INITRAMFS-AUC/KWS-SoC/(list of files, cad)

Other CAD files:
quartus/CycloneV/stp1.stp
