INITRAMFS-AUC/KWS-SoC/scripts/gen_pll.py

#!/usr/bin/env python3
"""
Generate a Quartus ALTPLL wrapper for any integer output frequency.

Strategy: patch the four synthesis-critical defparam values in
quartus/ip/ALTPLL_25/ALTPLL_25.v (wizard-generated, proven base) and
write the result as quartus/ip/clock_pll_gen/clock_pll_gen.v.
Everything else (port wiring, unused-port declarations, retrieval info)
is left byte-for-byte identical to the wizard output.

Usage:
    python3 scripts/gen_pll.py --clk-mhz 36 --device-family "Cyclone V"
"""

import argparse
import math
import os
import re
import sys

SCRIPT_DIR   = os.path.dirname(os.path.abspath(__file__))
REPO_ROOT    = os.path.dirname(SCRIPT_DIR)
TEMPLATE_V   = os.path.join(REPO_ROOT, "quartus/ip/ALTPLL_25/ALTPLL_25.v")
TEMPLATE_BB  = os.path.join(REPO_ROOT, "quartus/ip/ALTPLL_25/ALTPLL_25_bb.v")
OUT_DIR      = os.path.join(REPO_ROOT, "quartus/ip/clock_pll_gen")
MODULE_NAME  = "clock_pll_gen"
REF_MHZ      = 50

# Cyclone V ALTPLL hardware limits.  The VCO frequency (= REF_MHZ × M
# in lowest-terms M/C) must land inside the device's PLL VCO band, or
# Quartus will fail at fit time with a cryptic timing-closure error.
# These are the typical Cyclone V numbers; tighten if your specific
# speed grade differs.
VCO_MIN_MHZ  = 600
VCO_MAX_MHZ  = 1300

# ALTPLL counter ranges (M = multiplier, C = output divider).
M_MIN, M_MAX = 1,   256
C_MIN, C_MAX = 1,   512


def cyclone_v_admissible(clk_mhz):
    """True iff (M, C) for `clk_mhz` lands inside Cyclone V VCO + counter limits."""
    m, c = compute_mc(clk_mhz)
    if not (M_MIN <= m <= M_MAX): return False
    if not (C_MIN <= c <= C_MAX): return False
    vco = REF_MHZ * m
    return VCO_MIN_MHZ <= vco <= VCO_MAX_MHZ


def nearby_valid_clk_mhz(clk_mhz, span=12, target_count=4):
    """Adjacent CLK_MHZ values that DO meet the VCO/counter constraints,
    so the error message can suggest concrete alternatives.  Falls back
    to a globally-enumerated list if nothing is found within ±`span`."""
    candidates = []
    for delta in range(1, span + 1):
        for c in (clk_mhz - delta, clk_mhz + delta):
            if c <= 0: continue
            if cyclone_v_admissible(c):
                candidates.append(c)
        if len(candidates) >= target_count:
            break
    if candidates:
        return sorted(set(candidates))
    # Fallback: enumerate the practical CLK range and return a few.
    fallback = [c for c in range(1, 200) if cyclone_v_admissible(c)]
    return fallback[:target_count] if fallback else []


def compute_mc(clk_mhz):
    """Return (M, C) such that REF_MHZ * M / C == clk_mhz, in lowest terms."""
    g = math.gcd(clk_mhz, REF_MHZ)
    return clk_mhz // g, REF_MHZ // g


def patch(text, old_name, new_name, m, c, device_family, freq_mhz):
    """Apply all substitutions to the template text."""

    # --- Verilog body (synthesis-critical) ---
    text = re.sub(r'\bmodule\s+' + re.escape(old_name) + r'\b',
                  f'module {new_name}', text)
    text = re.sub(r'(altpll_component\.clk0_divide_by\s*=\s*)\d+',
                  rf'\g<1>{c}', text)
    text = re.sub(r'(altpll_component\.clk0_multiply_by\s*=\s*)\d+',
                  rf'\g<1>{m}', text)
    text = re.sub(r'(altpll_component\.intended_device_family\s*=\s*)"[^"]*"',
                  rf'\g<1>"{device_family}"', text)
    text = re.sub(r'(altpll_component\.lpm_hint\s*=\s*"CBX_MODULE_PREFIX=)' + re.escape(old_name) + r'"',
                  rf'\g<1>{new_name}"', text)

    # --- Retrieval-info comments (wizard bookkeeping only) ---
    text = re.sub(r'(CONSTANT: CLK0_DIVIDE_BY NUMERIC )"[^"]*"',
                  rf'\g<1>"{c}"', text)
    text = re.sub(r'(CONSTANT: CLK0_MULTIPLY_BY NUMERIC )"[^"]*"',
                  rf'\g<1>"{m}"', text)
    text = re.sub(r'(CONSTANT: INTENDED_DEVICE_FAMILY STRING )"[^"]*"',
                  rf'\g<1>"{device_family}"', text)
    text = re.sub(r'(PRIVATE: INTENDED_DEVICE_FAMILY STRING )"[^"]*"',
                  rf'\g<1>"{device_family}"', text)
    text = re.sub(r'(PRIVATE: OUTPUT_FREQ0 STRING )"[^"]*"',
                  rf'\g<1>"{freq_mhz:.8f}"', text)
    text = re.sub(r'(PRIVATE: EFF_OUTPUT_FREQ_VALUE0 STRING )"[^"]*"',
                  rf'\g<1>"{freq_mhz:.6f}"', text)

    # Rename all remaining old_name occurrences (GEN_FILE lines, file header comment, etc.)
    text = text.replace(old_name, new_name)

    return text


def write_qip(out_dir, module_name, device_family):
    qip_path = os.path.join(out_dir, f"{module_name}.qip")
    with open(qip_path, "w") as fh:
        fh.write(f'set_global_assignment -name IP_TOOL_NAME "ALTPLL"\n')
        fh.write(f'set_global_assignment -name IP_TOOL_VERSION "25.1"\n')
        fh.write(f'set_global_assignment -name IP_GENERATED_DEVICE_FAMILY "{{{device_family}}}"\n')
        fh.write(f'set_global_assignment -name VERILOG_FILE [file join $::quartus(qip_path) "{module_name}.v"]\n')
        fh.write(f'set_global_assignment -name MISC_FILE [file join $::quartus(qip_path) "{module_name}_bb.v"]\n')


def main():
    parser = argparse.ArgumentParser(description=__doc__,
                                     formatter_class=argparse.RawDescriptionHelpFormatter)
    parser.add_argument("--clk-mhz",      type=int,   required=True,
                        help="Target output frequency in MHz (integer)")
    parser.add_argument("--device-family", default="Cyclone V",
                        help="Intel FPGA device family (default: 'Cyclone V')")
    args = parser.parse_args()

    clk_mhz = args.clk_mhz
    m, c = compute_mc(clk_mhz)
    f_check = REF_MHZ * m / c
    if abs(f_check - clk_mhz) > 0.001:
        sys.exit(f"ERROR: {clk_mhz} MHz is not exactly achievable from {REF_MHZ} MHz as an integer ratio")

    # Hardware-feasibility checks.  Quartus will silently accept an
    # out-of-range VCO and only complain at fit time with an obscure
    # timing failure — fail loudly here instead so the user knows
    # immediately *why* their CLK_MHZ doesn't work.
    vco = REF_MHZ * m
    if not (M_MIN <= m <= M_MAX):
        nearby = nearby_valid_clk_mhz(clk_mhz)
        suggestion = f"Try one of: {', '.join(map(str, nearby))} MHz." if nearby \
                     else "(no admissible CLK_MHZ found near this value)"
        sys.exit(
            f"ERROR: CLK_MHZ={clk_mhz} requires M={m}, outside the\n"
            f"       Cyclone V ALTPLL multiplier range [{M_MIN}..{M_MAX}].\n"
            f"       {suggestion}")
    if not (C_MIN <= c <= C_MAX):
        nearby = nearby_valid_clk_mhz(clk_mhz)
        suggestion = f"Try one of: {', '.join(map(str, nearby))} MHz." if nearby \
                     else "(no admissible CLK_MHZ found near this value)"
        sys.exit(
            f"ERROR: CLK_MHZ={clk_mhz} requires C={c}, outside the\n"
            f"       Cyclone V ALTPLL output-divider range [{C_MIN}..{C_MAX}].\n"
            f"       {suggestion}")
    if not (VCO_MIN_MHZ <= vco <= VCO_MAX_MHZ):
        nearby = nearby_valid_clk_mhz(clk_mhz)
        suggestion = f"Try one of: {', '.join(map(str, nearby))} MHz." if nearby \
                     else "(no admissible CLK_MHZ found near this value)"
        sys.exit(
            f"ERROR: CLK_MHZ={clk_mhz} → M={m}, C={c} → VCO={vco} MHz,\n"
            f"       outside the Cyclone V ALTPLL VCO band\n"
            f"       [{VCO_MIN_MHZ}..{VCO_MAX_MHZ}] MHz.  Quartus would accept\n"
            f"       this but fail at fit-time timing closure.\n"
            f"       {suggestion}")
    print(f"[gen_pll] CLK_MHZ={clk_mhz} → M={m}, C={c}, VCO={vco} MHz (OK)")

    os.makedirs(OUT_DIR, exist_ok=True)

    old_name = "ALTPLL_25"

    for src, dst_name in [(TEMPLATE_V,  f"{MODULE_NAME}.v"),
                          (TEMPLATE_BB, f"{MODULE_NAME}_bb.v")]:
        with open(src) as fh:
            text = fh.read()
        text = patch(text, old_name, MODULE_NAME, m, c, args.device_family, float(clk_mhz))
        dst = os.path.join(OUT_DIR, dst_name)
        with open(dst, "w") as fh:
            fh.write(text)

    write_qip(OUT_DIR, MODULE_NAME, args.device_family)

    print(f"Generated {clk_mhz} MHz PLL (M={m}, C={c}, family={args.device_family!r}) → {OUT_DIR}/")


if __name__ == "__main__":
    main()
