INITRAMFS-AUC/KWS-SoC/test/i2s/c/readI2s.c

#include <stdint.h>
#include "uart.h"
#include "i2s_regs.h"

#define I2S_BASE_ADDR  0x40008000
#define I2S            ((i2s_hw_t *)I2S_BASE_ADDR)

/* Half-full threshold = FIFO_DEPTH/2; the Makefile derives I2S_DMA_BURST_WORDS
 * from the same root variable, so reading that many words per IRQ matches the
 * peripheral's interrupt point exactly. */
#ifndef I2S_DMA_BURST_WORDS
#error "I2S_DMA_BURST_WORDS must be defined by the Makefile"
#endif
#define I2S_HALF_FULL I2S_DMA_BURST_WORDS

/* One pattern pass from sim/debug_audio.hex (comments and blanks stripped).
 * These are the raw 32-bit I2S words fed by the simulator.
 * Firmware-equivalent quantization: (int8_t)(raw >> 16) == HW q8_en extraction.
 *
 * The first 2 entries are warmup zeros: the I2S clock generator fires two
 * phantom data_left_en pulses (first two WS frames) before the simulator
 * starts driving real data.  raw_data_l=0 during those frames, so bits[23:16]
 * are 0x00, and pack_cnt advances from 0->2 before the first real sample.
 * Prepending two 0x00000000 entries aligns expected[] with the received stream. */
static const uint32_t expected_raw[] = {
    /* Warmup: 2 phantom WS frames before simulator data begins */
    0x00000000, 0x00000000,
    /* Magic words */
    0xDEADBEEF, 0xCAFEBABE, 0x0BADF00D, 0xFACEFEED,
    /* Walking 1 */
    0x80000000, 0x40000000, 0x20000000, 0x10000000,
    0x08000000, 0x04000000, 0x02000000, 0x01000000,
    /* Walking 0 */
    0x7FFFFFFF, 0xBFFFFFFF, 0xDFFFFFFF, 0xEFFFFFFF,
    /* Counting */
    0x00000001, 0x00000002, 0x00000003, 0x00000004,
    0x00000005, 0x00000006, 0x00000007, 0x00000008,
    /* Alternating */
    0xAAAAAAAA, 0x55555555,
};
#define NUM_EXPECTED ((int)(sizeof(expected_raw) / sizeof(expected_raw[0])))

static volatile int exp_idx    = 0;
static volatile int pass_count = 0;
static volatile int fail_count = 0;
static volatile int done       = 0;

uint32_t i2s_get_id(void) {
    return I2S->id;
}

void i2s_configure(uint32_t clk_div, uint8_t int_en, uint8_t ds_en, uint8_t q8_en) {
    uint32_t conf_val = 0;
    conf_val |= ((clk_div << I2S_CONF_DIV_LSB)    & I2S_CONF_DIV_MASK);
    conf_val |= ((int_en  << I2S_CONF_IRQ_EN_LSB) & I2S_CONF_IRQ_EN_MASK);
    /* conf_val |= ((ds_en   << I2S_CONF_DS_EN_LSB)  & I2S_CONF_DS_EN_MASK); */
    /* q8_en=1 maps to WIDTH=8 (8-bit packing) in the new width-aware regblock. */
    if (q8_en)
        conf_val |= (((uint32_t)I2S_CONF_WIDTH_8 << I2S_CONF_WIDTH_LSB) & I2S_CONF_WIDTH_MASK);
    I2S->conf = conf_val;
}

void __attribute__((interrupt("machine"))) i2s_isr(void) {
    if (done) return;

    for (int i = 0; i < I2S_HALF_FULL; i++) {
        uint32_t word = I2S->fifo;  /* 4 packed HW-quantized int8 samples */

        for (int s = 24; s >= 0; s -= 8) {
            if (exp_idx >= NUM_EXPECTED) {
                done = 1;
                return;
            }

            /* HW-produced int8 (already quantized and packed by peripheral) */
            uint8_t rx  = (uint8_t)(word >> s);

            /* Firmware-equivalent: same extraction the HW performs on the raw word */
            uint8_t exp = (uint8_t)(expected_raw[exp_idx] >> 16);

            int ok = (rx == exp);
            uart_printf("[%x] rx=0x%x  exp=0x%x  %s\r\n",
                        (uint32_t)exp_idx, (uint32_t)rx, (uint32_t)exp,
                        ok ? "PASS" : "FAIL");

            if (ok) pass_count++; else fail_count++;
            exp_idx++;
        }
    }
}

static inline void csr_set_mtvec(void (*handler)(void)) {
    asm volatile ("csrw mtvec, %0" :: "r"((uintptr_t)handler));
}

static inline void csr_enable_meie(void) {
    asm volatile ("csrs mie, %0" :: "r"(1u << 11));
}

static inline void csr_enable_mie(void) {
    asm volatile ("csrsi mstatus, 8");
}

static inline void wfi(void) {
    asm volatile ("wfi");
}

int main(void) {
    uart_init();
    uart_printf("[I2S q8 test] ID: 0x%x\r\n", i2s_get_id());
    uart_printf("Expecting %x samples from debug_audio.hex\r\n\r\n",
                (uint32_t)NUM_EXPECTED);

    csr_set_mtvec(i2s_isr);
    csr_enable_meie();
    /* ds_en=0: no downsampling so all samples arrive in hex-file order.
     * q8_en=1: HW extracts raw[23:16] and packs 4 int8s per 32-bit FIFO word. */
    i2s_configure(4, 1, 0, 1);
    csr_enable_mie();

    while (!done) { wfi(); }

    uart_printf("\r\n=== RESULT: %x PASS  %x FAIL ===\r\n",
                (uint32_t)pass_count, (uint32_t)fail_count);
    return 0;
}
