INITRAMFS-AUC/KWS-SoC/test/uart/c/hello_world.c

#include <stdint.h>

// --- UART REGISTER DEFINITIONS ---
#define UART_BASE  0x40004000
#define UART_CSR   (*(volatile uint32_t *)(UART_BASE + 0x00))
#define UART_DIV   (*(volatile uint32_t *)(UART_BASE + 0x04))
// Assumes FSTAT is at offset 0x08 based on previous context
#define UART_FSTAT (*(volatile uint32_t *)(UART_BASE + 0x08))
#define UART_TX    (*(volatile uint32_t *)(UART_BASE + 0x0C))

#define UART_CSR_EN       (1 << 0)
#define UART_FSTAT_TXFULL (1 << 8) // Validated against "fstat_txfull_i" in Verilog

// --- CONFIGURATION ---
#ifndef CLK_MHZ
    #error "CLK_MHZ is not defined. Check your Makefile variables!"
#endif
#ifndef UART_BAUD_RATE
    #error "UART_BAUD_RATE is not defined. Check your Makefile variables!"
#endif

// --- BAUD CALCULATION ---
// Convert MHz to Hz
#define SYS_CLK_HZ  ((uint32_t)(CLK_MHZ * 1000000UL))

// Calculate Fractional Divisor - Based on uart_mini
// Hardware requires 8x Oversampling and uses 4 fractional bits (x16 scale).
// Formula: (CLK / (Baud * 8)) * 16  ==>  (CLK / Baud) * 2
// We apply rounding logic: ((2*CLK) + (Baud/2)) / Baud
#define UART_DIV_VAL  (((2 * SYS_CLK_HZ) + (UART_BAUD_RATE / 2)) / UART_BAUD_RATE)

void uart_init() {
    // Set the fractional divisor
    UART_DIV = UART_DIV_VAL;

    // Enable UART (Loopback, Interrupts etc. handled here if needed)
    UART_CSR |= UART_CSR_EN;
}

void uart_putc(char c) {
    // Wait for TX FIFO to be not full
    while (UART_FSTAT & UART_FSTAT_TXFULL);
    UART_TX = c;
}

void uart_puts(const char *s) {
    while (*s) uart_putc(*s++);
}

int main() {
    uart_init();
    while (1) {
        uart_puts("Hello World!\r\n");
    }
    return 0;
}
