INITRAMFS-AUC/KWS-SoC/test/model/mel_compact_int8_pi/mel_compact_int8_pi.h

#include "nnom.h"

/* Weights, bias and Q format */
#define TENSOR_CONV1D_MEL_KERNEL_0 {-30, -11, 15, 34, 45, 51, 45, 27, 20, -12, -34, -44, -53, -54, -52, -41, -35, -10, 23, 38, 56, 67, 67, 59, 42, 13, -5, -39, -66, -81, -81, -62, -50, -15, 2, 36, 50, 72, 68, 68, 46, 27, 0, -31, -48, -56, -58, -61, -55, -31, 2, 28, 51, 67, 63, 56, 41, 28, 2, -2, -23, -43, -48, -47, -36, -37, -37, -26, -33, -42, -56, -68, -64, -62, -66, -59, -54, -43, -35, -29, -16, -15, 8, 29, 46, 57, 63, 67, 78, 94, 92, 88, 82, 83, 83, 75, 63, 46, 32, 17, 13, -2, -23, -33, -43, -60, -63, -68, -68, -76, -73, -75, -75, -68, -60, -51, -40, -23, -12, -12, -5, 6, 2, 9, 17, 15, 11, 16, 15, 18, -9, 11, 23, 32, 44, 47, 59, 56, 55, 50, 48, 35, 27, 6, -10, -30, -45, -60, -70, -70, -70, -67, -62, -61, -42, -29, -10, 12, 30, 60, 64, 60, 68, 78, 74, 76, 77, 71, 61, 37, 18, 4, -6, -14, -25, -37, -51, -70, -69, -63, -55, -42, -34, -17, -7, 4, 8, 16, 22, 26, 48, 41, 37, 30, 34, 34, 14, -21, -30, -41, -30, -31, -30, -15, -10, 7, 32, 48, 79, 86, 76, 65, 43, 37, -9, -34, -60, -83, -92, -97, -76, -47, -21, -7, 20, 60, 94, 103, 108, 86, 62, 36, 3, -18, -45, -72, -84, -85, -67, -54, -33, -18, 13, 43, 55, 58, 69, 67, 53, 31, 13, -5, -11, -22, -22, -34, -32, -20, 6, 21, -22, -22, 2, 30, 29, 31, 31, 23, 8, -19, -30, -49, -51, -49, -30, -3, 24, 41, 60, 62, 58, 42, 15, -22, -53, -80, -87, -78, -51, -9, 32, 65, 94, 94, 90, 48, 6, -46, -86, -105, -104, -86, -40, 16, 69, 88, 97, 92, 55, 6, -35, -69, -75, -71, -59, -20, 13, 40, 40, 45, 37, 15, 8, -27, -33, 10, -1, -7, -15, -12, -4, 14, 27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

#define TENSOR_DENSE_FC_KERNEL_0_DEC_BITS {6}

#define TENSOR_DENSE_FC_BIAS_0 {42, 61, 21, 67, 6, 28, -30, 16, 104, 21, 5, -7, -2, 45, 11, -32}

#define TENSOR_DENSE_FC_BIAS_0_DEC_BITS {9}

#define DENSE_FC_BIAS_LSHIFT {0}

#define DENSE_FC_OUTPUT_RSHIFT {5}

#define TENSOR_DENSE_OUT_KERNEL_0 {14, -44, -40, -37, 18, -30, 15, -39, -40, -51, -27, -21, -40, -58, -43, 18, 19, 19, 18, 10, -54, 20, -50, -28, 26, -19, -42, 14, -42, -45, -45, 14, -22, -52, -39, -35, 26, -31, 18, 11, -37, -40, 16, 21, 12, -45, -12, -10, -25, 18, -31, 21, -11, -38, -12, 20, -33, -53, 15, -30, -43, -53, 14, 12, -46, 15, 11, -36, 20, -43, -26, 16, 21, 21, 17, 14, 22, -25, -28, -27, -43, 9, 7, 13, -37, -48, 13, 16, -23, 22, 15, 9, -37, 24, -33, 6, 7, 24, -42, -56, 27, -22, 14, -49, 7, -39, -61, -55, -22, 12, 16, 6, -10, -52, -45, -33, -32, 31, 20, -47, 16, 17, -1, -41, -42, -25, -54, -30, -50, 20, 12, 13, -85, 16, -41, 9, 23, 9, 2, -62, 21, 12, -72, -62, -27, -40, 17, -51, -49, -60, -55, -51, -20, 14, 12, 18, -38, -26, 18, 15, 5, 14, -49, -67, 8, 10, -20, -43, -47, -53, 12, -28, 31, 17, 9, -32}

#define TENSOR_DENSE_OUT_KERNEL_0_DEC_BITS {5}

#define TENSOR_DENSE_OUT_BIAS_0 {34, 51, 16, 45, -64, -102, -39, -1, -92, 36, 77}

#define TENSOR_DENSE_OUT_BIAS_0_DEC_BITS {7}

#define DENSE_OUT_BIAS_LSHIFT {3}

#define DENSE_OUT_OUTPUT_RSHIFT {9}


/* output q format for each layer */
#define AUDIO_INPUT_OUTPUT_DEC 7
#define AUDIO_INPUT_OUTPUT_OFFSET 0
#define CONV1D_MEL_OUTPUT_DEC 4
#define CONV1D_MEL_OUTPUT_OFFSET 0
#define BATCH_NORMALIZATION_1_OUTPUT_DEC 4
#define BATCH_NORMALIZATION_1_OUTPUT_OFFSET 0
#define RE_LU_1_OUTPUT_DEC 4
#define RE_LU_1_OUTPUT_OFFSET 0
#define MAX_POOLING_2_OUTPUT_DEC 4
#define MAX_POOLING_2_OUTPUT_OFFSET 0
#define CONV1D_2_OUTPUT_DEC 3
#define CONV1D_2_OUTPUT_OFFSET 0
#define BATCH_NORMALIZATION_2_OUTPUT_DEC 3
#define BATCH_NORMALIZATION_2_OUTPUT_OFFSET 0
#define RE_LU_2_OUTPUT_DEC 3
#define RE_LU_2_OUTPUT_OFFSET 0
#define MAX_POOLING_3_OUTPUT_DEC 3
#define MAX_POOLING_3_OUTPUT_OFFSET 0
#define CONV1D_3_OUTPUT_DEC 4
#define CONV1D_3_OUTPUT_OFFSET 0
#define BATCH_NORMALIZATION_3_OUTPUT_DEC 4
#define BATCH_NORMALIZATION_3_OUTPUT_OFFSET 0
#define RE_LU_3_OUTPUT_DEC 4
#define RE_LU_3_OUTPUT_OFFSET 0
#define MAX_POOLING_4_OUTPUT_DEC 4
#define MAX_POOLING_4_OUTPUT_OFFSET 0
#define CONV1D_4_OUTPUT_DEC 4
#define CONV1D_4_OUTPUT_OFFSET 0
#define BATCH_NORMALIZATION_4_OUTPUT_DEC 4
#define BATCH_NORMALIZATION_4_OUTPUT_OFFSET 0
#define RE_LU_4_OUTPUT_DEC 4
#define RE_LU_4_OUTPUT_OFFSET 0
#define CONV1D_5_OUTPUT_DEC 3
#define CONV1D_5_OUTPUT_OFFSET 0
#define BATCH_NORMALIZATION_5_OUTPUT_DEC 3
#define BATCH_NORMALIZATION_5_OUTPUT_OFFSET 0
#define RE_LU_5_OUTPUT_DEC 3
#define RE_LU_5_OUTPUT_OFFSET 0
#define GLOBAL_AVERAGE_POOLING_OUTPUT_DEC 3
#define GLOBAL_AVERAGE_POOLING_OUTPUT_OFFSET 0
#define DENSE_FC_OUTPUT_DEC 4
#define DENSE_FC_OUTPUT_OFFSET 0
#define RE_LU_FC_OUTPUT_DEC 5
#define RE_LU_FC_OUTPUT_OFFSET 0
#define DROPOUT_OUTPUT_DEC 5
#define DROPOUT_OUTPUT_OFFSET 0
#define DENSE_OUT_OUTPUT_DEC 1
#define DENSE_OUT_OUTPUT_OFFSET 0
#define SOFTMAX_OUTPUT_DEC 7
#define SOFTMAX_OUTPUT_OFFSET 0

/* bias shift and output shift for none-weighted layer */

/* tensors and configurations for each layer */
static int8_t nnom_input_data[8000] = {0};

const nnom_shape_data_t tensor_audio_input_dim[] = {8000, 1};
const nnom_qformat_param_t tensor_audio_input_dec[] = {7};
const nnom_qformat_param_t tensor_audio_input_offset[] = {0};
const nnom_tensor_t tensor_audio_input = {
    .p_data = (void*)nnom_input_data,
    .dim = (nnom_shape_data_t*)tensor_audio_input_dim,
    .q_dec = (nnom_qformat_param_t*)tensor_audio_input_dec,
    .q_offset = (nnom_qformat_param_t*)tensor_audio_input_offset,
    .qtype = NNOM_QTYPE_PER_TENSOR,
    .num_dim = 2,
    .bitwidth = 8
};

const nnom_io_config_t audio_input_config = {
    .super = {.name = "audio_input"},
    .tensor = (nnom_tensor_t*)&tensor_audio_input
};
const int8_t tensor_conv1d_mel_kernel_0_data[] = TENSOR_CONV1D_MEL_KERNEL_0;

const nnom_shape_data_t tensor_conv1d_mel_kernel_0_dim[] = {65, 1, 16};
const nnom_qformat_param_t tensor_conv1d_mel_kernel_0_dec[] = TENSOR_CONV1D_MEL_KERNEL_0_DEC_BITS;
const nnom_qformat_param_t tensor_conv1d_mel_kernel_0_offset[] = {0};
const nnom_tensor_t tensor_conv1d_mel_kernel_0 = {
    .p_data = (void*)tensor_conv1d_mel_kernel_0_data,
    .dim = (nnom_shape_data_t*)tensor_conv1d_mel_kernel_0_dim,
    .q_dec = (nnom_qformat_param_t*)tensor_conv1d_mel_kernel_0_dec,
    .q_offset = (nnom_qformat_param_t*)tensor_conv1d_mel_kernel_0_offset,
    .qtype = NNOM_QTYPE_PER_AXIS,
    .num_dim = 3,
    .bitwidth = 8
};
const int8_t tensor_conv1d_mel_bias_0_data[] = TENSOR_CONV1D_MEL_BIAS_0;

const nnom_shape_data_t tensor_conv1d_mel_bias_0_dim[] = {16};
const nnom_qformat_param_t tensor_conv1d_mel_bias_0_dec[] = TENSOR_CONV1D_MEL_BIAS_0_DEC_BITS;
const nnom_qformat_param_t tensor_conv1d_mel_bias_0_offset[] = {0};
const nnom_tensor_t tensor_conv1d_mel_bias_0 = {
    .p_data = (void*)tensor_conv1d_mel_bias_0_data,
    .dim = (nnom_shape_data_t*)tensor_conv1d_mel_bias_0_dim,
    .q_dec = (nnom_qformat_param_t*)tensor_conv1d_mel_bias_0_dec,
    .q_offset = (nnom_qformat_param_t*)tensor_conv1d_mel_bias_0_offset,
    .qtype = NNOM_QTYPE_PER_AXIS,
    .num_dim = 1,
    .bitwidth = 8
};

const nnom_qformat_param_t conv1d_mel_output_shift[] = CONV1D_MEL_OUTPUT_RSHIFT;
const nnom_qformat_param_t conv1d_mel_bias_shift[] = CONV1D_MEL_BIAS_LSHIFT;
const nnom_conv2d_config_t conv1d_mel_config = {
    .super = {.name = "conv1d_mel"},
    .qtype = NNOM_QTYPE_PER_TENSOR,
    .weight = (nnom_tensor_t*)&tensor_conv1d_mel_kernel_0,
    .bias = (nnom_tensor_t*)&tensor_conv1d_mel_bias_0,
    .output_shift = (nnom_qformat_param_t *)&conv1d_mel_output_shift, 
    .bias_shift = (nnom_qformat_param_t *)&conv1d_mel_bias_shift, 
    .filter_size = 16,
    .kernel_size = {65},
    .stride_size = {16},
    .padding_size = {0, 0},
    .dilation_size = {1},
    .padding_type = PADDING_VALID
};

const nnom_pool_config_t max_pooling_2_config = {
    .super = {.name = "max_pooling_2"},
    .padding_type = PADDING_VALID,
    .output_shift = 0,
    .kernel_size = {4},
    .stride_size = {4},
    .num_dim = 1
};
const int8_t tensor_conv1d_2_kernel_0_data[] = TENSOR_CONV1D_2_KERNEL_0;

const nnom_shape_data_t tensor_conv1d_2_kernel_0_dim[] = {3, 16, 36};
const nnom_qformat_param_t tensor_conv1d_2_kernel_0_dec[] = TENSOR_CONV1D_2_KERNEL_0_DEC_BITS;
const nnom_qformat_param_t tensor_conv1d_2_kernel_0_offset[] = {0};
const nnom_tensor_t tensor_conv1d_2_kernel_0 = {
    .p_data = (void*)tensor_conv1d_2_kernel_0_data,
    .dim = (nnom_shape_data_t*)tensor_conv1d_2_kernel_0_dim,
    .q_dec = (nnom_qformat_param_t*)tensor_conv1d_2_kernel_0_dec,
    .q_offset = (nnom_qformat_param_t*)tensor_conv1d_2_kernel_0_offset,
    .qtype = NNOM_QTYPE_PER_AXIS,
    .num_dim = 3,
    .bitwidth = 8
};
const int8_t tensor_conv1d_2_bias_0_data[] = TENSOR_CONV1D_2_BIAS_0;

const nnom_shape_data_t tensor_conv1d_2_bias_0_dim[] = {36};
const nnom_qformat_param_t tensor_conv1d_2_bias_0_dec[] = TENSOR_CONV1D_2_BIAS_0_DEC_BITS;
const nnom_qformat_param_t tensor_conv1d_2_bias_0_offset[] = {0};
const nnom_tensor_t tensor_conv1d_2_bias_0 = {
    .p_data = (void*)tensor_conv1d_2_bias_0_data,
    .dim = (nnom_shape_data_t*)tensor_conv1d_2_bias_0_dim,
    .q_dec = (nnom_qformat_param_t*)tensor_conv1d_2_bias_0_dec,
    .q_offset = (nnom_qformat_param_t*)tensor_conv1d_2_bias_0_offset,
    .qtype = NNOM_QTYPE_PER_AXIS,
    .num_dim = 1,
    .bitwidth = 8
};

const nnom_qformat_param_t conv1d_2_output_shift[] = CONV1D_2_OUTPUT_RSHIFT;
const nnom_qformat_param_t conv1d_2_bias_shift[] = CONV1D_2_BIAS_LSHIFT;
const nnom_conv2d_config_t conv1d_2_config = {
    .super = {.name = "conv1d_2"},
    .qtype = NNOM_QTYPE_PER_TENSOR,
    .weight = (nnom_tensor_t*)&tensor_conv1d_2_kernel_0,
    .bias = (nnom_tensor_t*)&tensor_conv1d_2_bias_0,
    .output_shift = (nnom_qformat_param_t *)&conv1d_2_output_shift, 
    .bias_shift = (nnom_qformat_param_t *)&conv1d_2_bias_shift, 
    .filter_size = 36,
    .kernel_size = {3},
    .stride_size = {1},
    .padding_size = {0, 0},
    .dilation_size = {1},
    .padding_type = PADDING_SAME
};

const nnom_pool_config_t max_pooling_3_config = {
    .super = {.name = "max_pooling_3"},
    .padding_type = PADDING_VALID,
    .output_shift = 0,
    .kernel_size = {4},
    .stride_size = {4},
    .num_dim = 1
};
const int8_t tensor_conv1d_3_kernel_0_data[] = TENSOR_CONV1D_3_KERNEL_0;

const nnom_shape_data_t tensor_conv1d_3_kernel_0_dim[] = {3, 36, 36};
const nnom_qformat_param_t tensor_conv1d_3_kernel_0_dec[] = TENSOR_CONV1D_3_KERNEL_0_DEC_BITS;
const nnom_qformat_param_t tensor_conv1d_3_kernel_0_offset[] = {0};
const nnom_tensor_t tensor_conv1d_3_kernel_0 = {
    .p_data = (void*)tensor_conv1d_3_kernel_0_data,
    .dim = (nnom_shape_data_t*)tensor_conv1d_3_kernel_0_dim,
    .q_dec = (nnom_qformat_param_t*)tensor_conv1d_3_kernel_0_dec,
    .q_offset = (nnom_qformat_param_t*)tensor_conv1d_3_kernel_0_offset,
    .qtype = NNOM_QTYPE_PER_AXIS,
    .num_dim = 3,
    .bitwidth = 8
};
const int8_t tensor_conv1d_3_bias_0_data[] = TENSOR_CONV1D_3_BIAS_0;

const nnom_shape_data_t tensor_conv1d_3_bias_0_dim[] = {36};
const nnom_qformat_param_t tensor_conv1d_3_bias_0_dec[] = TENSOR_CONV1D_3_BIAS_0_DEC_BITS;
const nnom_qformat_param_t tensor_conv1d_3_bias_0_offset[] = {0};
const nnom_tensor_t tensor_conv1d_3_bias_0 = {
    .p_data = (void*)tensor_conv1d_3_bias_0_data,
    .dim = (nnom_shape_data_t*)tensor_conv1d_3_bias_0_dim,
    .q_dec = (nnom_qformat_param_t*)tensor_conv1d_3_bias_0_dec,
    .q_offset = (nnom_qformat_param_t*)tensor_conv1d_3_bias_0_offset,
    .qtype = NNOM_QTYPE_PER_AXIS,
    .num_dim = 1,
    .bitwidth = 8
};

const nnom_qformat_param_t conv1d_3_output_shift[] = CONV1D_3_OUTPUT_RSHIFT;
const nnom_qformat_param_t conv1d_3_bias_shift[] = CONV1D_3_BIAS_LSHIFT;
const nnom_conv2d_config_t conv1d_3_config = {
    .super = {.name = "conv1d_3"},
    .qtype = NNOM_QTYPE_PER_TENSOR,
    .weight = (nnom_tensor_t*)&tensor_conv1d_3_kernel_0,
    .bias = (nnom_tensor_t*)&tensor_conv1d_3_bias_0,
    .output_shift = (nnom_qformat_param_t *)&conv1d_3_output_shift, 
    .bias_shift = (nnom_qformat_param_t *)&conv1d_3_bias_shift, 
    .filter_size = 36,
    .kernel_size = {3},
    .stride_size = {1},
    .padding_size = {0, 0},
    .dilation_size = {1},
    .padding_type = PADDING_SAME
};

const nnom_pool_config_t max_pooling_4_config = {
    .super = {.name = "max_pooling_4"},
    .padding_type = PADDING_VALID,
    .output_shift = 0,
    .kernel_size = {2},
    .stride_size = {2},
    .num_dim = 1
};
const int8_t tensor_conv1d_4_kernel_0_data[] = TENSOR_CONV1D_4_KERNEL_0;

const nnom_shape_data_t tensor_conv1d_4_kernel_0_dim[] = {3, 36, 36};
const nnom_qformat_param_t tensor_conv1d_4_kernel_0_dec[] = TENSOR_CONV1D_4_KERNEL_0_DEC_BITS;
const nnom_qformat_param_t tensor_conv1d_4_kernel_0_offset[] = {0};
const nnom_tensor_t tensor_conv1d_4_kernel_0 = {
    .p_data = (void*)tensor_conv1d_4_kernel_0_data,
    .dim = (nnom_shape_data_t*)tensor_conv1d_4_kernel_0_dim,
    .q_dec = (nnom_qformat_param_t*)tensor_conv1d_4_kernel_0_dec,
    .q_offset = (nnom_qformat_param_t*)tensor_conv1d_4_kernel_0_offset,
    .qtype = NNOM_QTYPE_PER_AXIS,
    .num_dim = 3,
    .bitwidth = 8
};
const int8_t tensor_conv1d_4_bias_0_data[] = TENSOR_CONV1D_4_BIAS_0;

const nnom_shape_data_t tensor_conv1d_4_bias_0_dim[] = {36};
const nnom_qformat_param_t tensor_conv1d_4_bias_0_dec[] = TENSOR_CONV1D_4_BIAS_0_DEC_BITS;
const nnom_qformat_param_t tensor_conv1d_4_bias_0_offset[] = {0};
const nnom_tensor_t tensor_conv1d_4_bias_0 = {
    .p_data = (void*)tensor_conv1d_4_bias_0_data,
    .dim = (nnom_shape_data_t*)tensor_conv1d_4_bias_0_dim,
    .q_dec = (nnom_qformat_param_t*)tensor_conv1d_4_bias_0_dec,
    .q_offset = (nnom_qformat_param_t*)tensor_conv1d_4_bias_0_offset,
    .qtype = NNOM_QTYPE_PER_AXIS,
    .num_dim = 1,
    .bitwidth = 8
};

const nnom_qformat_param_t conv1d_4_output_shift[] = CONV1D_4_OUTPUT_RSHIFT;
const nnom_qformat_param_t conv1d_4_bias_shift[] = CONV1D_4_BIAS_LSHIFT;
const nnom_conv2d_config_t conv1d_4_config = {
    .super = {.name = "conv1d_4"},
    .qtype = NNOM_QTYPE_PER_TENSOR,
    .weight = (nnom_tensor_t*)&tensor_conv1d_4_kernel_0,
    .bias = (nnom_tensor_t*)&tensor_conv1d_4_bias_0,
    .output_shift = (nnom_qformat_param_t *)&conv1d_4_output_shift, 
    .bias_shift = (nnom_qformat_param_t *)&conv1d_4_bias_shift, 
    .filter_size = 36,
    .kernel_size = {3},
    .stride_size = {1},
    .padding_size = {0, 0},
    .dilation_size = {1},
    .padding_type = PADDING_SAME
};
const int8_t tensor_conv1d_5_kernel_0_data[] = TENSOR_CONV1D_5_KERNEL_0;

const nnom_shape_data_t tensor_conv1d_5_kernel_0_dim[] = {3, 36, 36};
const nnom_qformat_param_t tensor_conv1d_5_kernel_0_dec[] = TENSOR_CONV1D_5_KERNEL_0_DEC_BITS;
const nnom_qformat_param_t tensor_conv1d_5_kernel_0_offset[] = {0};
const nnom_tensor_t tensor_conv1d_5_kernel_0 = {
    .p_data = (void*)tensor_conv1d_5_kernel_0_data,
    .dim = (nnom_shape_data_t*)tensor_conv1d_5_kernel_0_dim,
    .q_dec = (nnom_qformat_param_t*)tensor_conv1d_5_kernel_0_dec,
    .q_offset = (nnom_qformat_param_t*)tensor_conv1d_5_kernel_0_offset,
    .qtype = NNOM_QTYPE_PER_AXIS,
    .num_dim = 3,
    .bitwidth = 8
};
const int8_t tensor_conv1d_5_bias_0_data[] = TENSOR_CONV1D_5_BIAS_0;

const nnom_shape_data_t tensor_conv1d_5_bias_0_dim[] = {36};
const nnom_qformat_param_t tensor_conv1d_5_bias_0_dec[] = TENSOR_CONV1D_5_BIAS_0_DEC_BITS;
const nnom_qformat_param_t tensor_conv1d_5_bias_0_offset[] = {0};
const nnom_tensor_t tensor_conv1d_5_bias_0 = {
    .p_data = (void*)tensor_conv1d_5_bias_0_data,
    .dim = (nnom_shape_data_t*)tensor_conv1d_5_bias_0_dim,
    .q_dec = (nnom_qformat_param_t*)tensor_conv1d_5_bias_0_dec,
    .q_offset = (nnom_qformat_param_t*)tensor_conv1d_5_bias_0_offset,
    .qtype = NNOM_QTYPE_PER_AXIS,
    .num_dim = 1,
    .bitwidth = 8
};

const nnom_qformat_param_t conv1d_5_output_shift[] = CONV1D_5_OUTPUT_RSHIFT;
const nnom_qformat_param_t conv1d_5_bias_shift[] = CONV1D_5_BIAS_LSHIFT;
const nnom_conv2d_config_t conv1d_5_config = {
    .super = {.name = "conv1d_5"},
    .qtype = NNOM_QTYPE_PER_TENSOR,
    .weight = (nnom_tensor_t*)&tensor_conv1d_5_kernel_0,
    .bias = (nnom_tensor_t*)&tensor_conv1d_5_bias_0,
    .output_shift = (nnom_qformat_param_t *)&conv1d_5_output_shift, 
    .bias_shift = (nnom_qformat_param_t *)&conv1d_5_bias_shift, 
    .filter_size = 36,
    .kernel_size = {3},
    .stride_size = {1},
    .padding_size = {0, 0},
    .dilation_size = {1},
    .padding_type = PADDING_SAME
};

const nnom_global_pool_config_t global_average_pooling_config = {
    .super = {.name = "global_average_pooling"},
    .output_shift = 0,
};
const int8_t tensor_dense_fc_kernel_0_data[] = TENSOR_DENSE_FC_KERNEL_0;

const nnom_shape_data_t tensor_dense_fc_kernel_0_dim[] = {36, 16};
const nnom_qformat_param_t tensor_dense_fc_kernel_0_dec[] = TENSOR_DENSE_FC_KERNEL_0_DEC_BITS;
const nnom_qformat_param_t tensor_dense_fc_kernel_0_offset[] = {0};
const nnom_tensor_t tensor_dense_fc_kernel_0 = {
    .p_data = (void*)tensor_dense_fc_kernel_0_data,
    .dim = (nnom_shape_data_t*)tensor_dense_fc_kernel_0_dim,
    .q_dec = (nnom_qformat_param_t*)tensor_dense_fc_kernel_0_dec,
    .q_offset = (nnom_qformat_param_t*)tensor_dense_fc_kernel_0_offset,
    .qtype = NNOM_QTYPE_PER_TENSOR,
    .num_dim = 2,
    .bitwidth = 8
};
const int8_t tensor_dense_fc_bias_0_data[] = TENSOR_DENSE_FC_BIAS_0;

const nnom_shape_data_t tensor_dense_fc_bias_0_dim[] = {16};
const nnom_qformat_param_t tensor_dense_fc_bias_0_dec[] = TENSOR_DENSE_FC_BIAS_0_DEC_BITS;
const nnom_qformat_param_t tensor_dense_fc_bias_0_offset[] = {0};
const nnom_tensor_t tensor_dense_fc_bias_0 = {
    .p_data = (void*)tensor_dense_fc_bias_0_data,
    .dim = (nnom_shape_data_t*)tensor_dense_fc_bias_0_dim,
    .q_dec = (nnom_qformat_param_t*)tensor_dense_fc_bias_0_dec,
    .q_offset = (nnom_qformat_param_t*)tensor_dense_fc_bias_0_offset,
    .qtype = NNOM_QTYPE_PER_TENSOR,
    .num_dim = 1,
    .bitwidth = 8
};

const nnom_qformat_param_t dense_fc_output_shift[] = DENSE_FC_OUTPUT_RSHIFT;
const nnom_qformat_param_t dense_fc_bias_shift[] = DENSE_FC_BIAS_LSHIFT;
const nnom_dense_config_t dense_fc_config = {
    .super = {.name = "dense_fc"},
    .qtype = NNOM_QTYPE_PER_TENSOR,
    .weight = (nnom_tensor_t*)&tensor_dense_fc_kernel_0,
    .bias = (nnom_tensor_t*)&tensor_dense_fc_bias_0,
    .output_shift = (nnom_qformat_param_t *)&dense_fc_output_shift,
    .bias_shift = (nnom_qformat_param_t *)&dense_fc_bias_shift
};
const int8_t tensor_dense_out_kernel_0_data[] = TENSOR_DENSE_OUT_KERNEL_0;

const nnom_shape_data_t tensor_dense_out_kernel_0_dim[] = {16, 11};
const nnom_qformat_param_t tensor_dense_out_kernel_0_dec[] = TENSOR_DENSE_OUT_KERNEL_0_DEC_BITS;
const nnom_qformat_param_t tensor_dense_out_kernel_0_offset[] = {0};
const nnom_tensor_t tensor_dense_out_kernel_0 = {
    .p_data = (void*)tensor_dense_out_kernel_0_data,
    .dim = (nnom_shape_data_t*)tensor_dense_out_kernel_0_dim,
    .q_dec = (nnom_qformat_param_t*)tensor_dense_out_kernel_0_dec,
    .q_offset = (nnom_qformat_param_t*)tensor_dense_out_kernel_0_offset,
    .qtype = NNOM_QTYPE_PER_TENSOR,
    .num_dim = 2,
    .bitwidth = 8
};
const int8_t tensor_dense_out_bias_0_data[] = TENSOR_DENSE_OUT_BIAS_0;

const nnom_shape_data_t tensor_dense_out_bias_0_dim[] = {11};
const nnom_qformat_param_t tensor_dense_out_bias_0_dec[] = TENSOR_DENSE_OUT_BIAS_0_DEC_BITS;
const nnom_qformat_param_t tensor_dense_out_bias_0_offset[] = {0};
const nnom_tensor_t tensor_dense_out_bias_0 = {
    .p_data = (void*)tensor_dense_out_bias_0_data,
    .dim = (nnom_shape_data_t*)tensor_dense_out_bias_0_dim,
    .q_dec = (nnom_qformat_param_t*)tensor_dense_out_bias_0_dec,
    .q_offset = (nnom_qformat_param_t*)tensor_dense_out_bias_0_offset,
    .qtype = NNOM_QTYPE_PER_TENSOR,
    .num_dim = 1,
    .bitwidth = 8
};

const nnom_qformat_param_t dense_out_output_shift[] = DENSE_OUT_OUTPUT_RSHIFT;
const nnom_qformat_param_t dense_out_bias_shift[] = DENSE_OUT_BIAS_LSHIFT;
const nnom_dense_config_t dense_out_config = {
    .super = {.name = "dense_out"},
    .qtype = NNOM_QTYPE_PER_TENSOR,
    .weight = (nnom_tensor_t*)&tensor_dense_out_kernel_0,
    .bias = (nnom_tensor_t*)&tensor_dense_out_bias_0,
    .output_shift = (nnom_qformat_param_t *)&dense_out_output_shift,
    .bias_shift = (nnom_qformat_param_t *)&dense_out_bias_shift
};

const nnom_softmax_config_t softmax_config = {
    .super = {.name = "softmax"}
};
static int8_t nnom_output_data[11] = {0};

const nnom_shape_data_t tensor_output0_dim[] = {11};
const nnom_qformat_param_t tensor_output0_dec[] = {SOFTMAX_OUTPUT_DEC};
const nnom_qformat_param_t tensor_output0_offset[] = {0};
const nnom_tensor_t tensor_output0 = {
    .p_data = (void*)nnom_output_data,
    .dim = (nnom_shape_data_t*)tensor_output0_dim,
    .q_dec = (nnom_qformat_param_t*)tensor_output0_dec,
    .q_offset = (nnom_qformat_param_t*)tensor_output0_offset,
    .qtype = NNOM_QTYPE_PER_TENSOR,
    .num_dim = 1,
    .bitwidth = 8
};

const nnom_io_config_t output0_config = {
    .super = {.name = "output0"},
    .tensor = (nnom_tensor_t*)&tensor_output0
};
/* model version */
#define NNOM_MODEL_VERSION (10000*0 + 100*4 + 3)

/* nnom model */
static nnom_model_t* nnom_model_create(void)
{
	static nnom_model_t model;
	nnom_layer_t* layer[20];

	check_model_version(NNOM_MODEL_VERSION);
	new_model(&model);

	layer[0] = input_s(&audio_input_config);
	layer[1] = model.hook(conv2d_s(&conv1d_mel_config), layer[0]);
	layer[2] = model.active(act_relu(), layer[1]);
	layer[3] = model.hook(maxpool_s(&max_pooling_2_config), layer[2]);
	layer[4] = model.hook(conv2d_s(&conv1d_2_config), layer[3]);
	layer[5] = model.active(act_relu(), layer[4]);
	layer[6] = model.hook(maxpool_s(&max_pooling_3_config), layer[5]);
	layer[7] = model.hook(conv2d_s(&conv1d_3_config), layer[6]);
	layer[8] = model.active(act_relu(), layer[7]);
	layer[9] = model.hook(maxpool_s(&max_pooling_4_config), layer[8]);
	layer[10] = model.hook(conv2d_s(&conv1d_4_config), layer[9]);
	layer[11] = model.active(act_relu(), layer[10]);
	layer[12] = model.hook(conv2d_s(&conv1d_5_config), layer[11]);
	layer[13] = model.active(act_relu(), layer[12]);
	layer[14] = model.hook(global_avgpool_s(&global_average_pooling_config), layer[13]);
	layer[15] = model.hook(dense_s(&dense_fc_config), layer[14]);
	layer[16] = model.active(act_relu(), layer[15]);
	layer[17] = model.hook(dense_s(&dense_out_config), layer[16]);
	layer[18] = model.hook(softmax_s(&softmax_config), layer[17]);
	layer[19] = model.hook(output_s(&output0_config), layer[18]);
	model_compile(&model, layer[0], layer[19]);
	return &model;
}
