INITRAMFS-AUC/KWS-SoC/test/model/mel_compact_4cmd/weights_4cmd.h

#include "nnom.h"

/* Model metadata — consumed by kws_bare_main.c */
#define KWS_NUM_CLASSES 5
#define KWS_CLASS_NAMES {"go","left","right","stop","unknown"}

/* Weights, bias and Q format */
#define TENSOR_CONV1D_MEL_KERNEL_0 {20, 20, 20, 19, 21, 23, 25, 25, 25, 22, 21, 13, 2, 2, -7, -14, -23, -26, -39, -46, -52, -59, -65, -73, -80, -80, -80, -80, -76, -73, -63, -57, -49, -31, -22, -5, 3, 13, 25, 31, 43, 47, 53, 54, 56, 56, 57, 57, 57, 55, 48, 40, 35, 30, 21, 19, 11, 9, 5, 4, 3, 2, 1, 1, 0, -3, 13, 15, 18, 25, 30, 31, 31, 31, 26, 23, 18, 15, 10, -12, -28, -36, -38, -45, -49, -51, -51, -49, -46, -39, -34, -22, 0, 15, 26, 35, 37, 51, 68, 68, 68, 65, 54, 50, 40, 26, 9, -6, -17, -29, -42, -53, -58, -58, -57, -57, -49, -46, -29, -16, 0, 9, 19, 24, 26, 27, 27, 28, 29, 29, -25, -24, -17, -6, -2, 5, 9, 14, 27, 34, 35, 35, 24, 17, 8, -14, -39, -54, -56, -56, -56, -55, -41, -24, 3, 30, 46, 64, 79, 80, 80, 73, 47, 24, 1, -25, -48, -62, -73, -72, -71, -60, -41, -18, 0, 17, 29, 37, 39, 41, 40, 32, 28, 12, -1, -7, -10, -11, -13, -14, -14, -13, -1, 1, 1, 63, 49, 41, 40, 29, 1, -10, -45, -52, -70, -70, -70, -63, -28, 15, 59, 85, 91, 93, 94, 75, 53, -13, -52, -84, -100, -116, -116, -111, -75, -27, 20, 74, 84, 116, 119, 119, 115, 60, 21, -26, -68, -107, -111, -110, -102, -73, -34, 16, 60, 80, 92, 94, 92, 78, 27, -21, -21, -43, -58, -62, -62, -40, -6, 75, 29, 22, 21, 13, 9, 8, -11, -27, -36, -36, -35, -32, -11, 24, 49, 64, 64, 60, 29, 8, -23, -46, -69, -71, -68, -43, -3, 22, 63, 79, 84, 84, 50, 4, -41, -63, -85, -85, -71, -37, 2, 37, 72, 72, 71, 58, 33, 3, -31, -53, -62, -61, -53, -25, 0, 25, 44, 46, 41, 24, 11, -8, -17, -23, -38, 14, 1, -9, -27, -26, -24, -8, 15, 27, 41, 41, 37, 5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

#define CONV1D_3_BIAS_LSHIFT {5, 4, 4, 4, 2, 4, 3, 5, 4, 3, 2, 3, 3, 5, 0, 2, 6, 3, 5, 6, 5, 4, 6, 6, 5, 3, 6, 2, 6, 6, 2, 1, 5, 5, 4, 4}

#define CONV1D_3_OUTPUT_RSHIFT {7, 6, 6, 6, 6, 6, 7, 6, 6, 7, 6, 6, 6, 7, 7, 6, 6, 7, 8, 7, 7, 6, 7, 7, 7, 7, 7, 6, 8, 7, 7, 7, 7, 7, 7, 7}
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
