INITRAMFS-AUC/KWS-SoC/test/model/mel_compact_int8_pi_kld/mel_compact_int8_pi_kld_weights.h

#include "nnom.h"

/* Weights, bias and Q format */
#define TENSOR_CONV1D_MEL_KERNEL_0 {19, 18, 18, 18, 22, 25, 26, 26, 26, 21, 21, 13, 2, 1, -8, -14, -21, -25, -34, -42, -48, -54, -59, -67, -73, -73, -73, -73, -70, -68, -59, -53, -46, -28, -20, -5, 2, 14, 23, 29, 39, 44, 50, 51, 51, 51, 53, 53, 51, 51, 44, 36, 33, 29, 21, 19, 11, 9, 4, 3, 2, 2, 0, -1, -1, -5, 12, 14, 16, 24, 29, 30, 31, 31, 25, 23, 19, 16, 9, -10, -26, -36, -37, -42, -48, -51, -51, -50, -46, -40, -34, -23, -3, 12, 22, 31, 35, 50, 65, 65, 65, 61, 50, 48, 37, 24, 8, -8, -19, -29, -44, -53, -57, -58, -57, -56, -49, -46, -30, -19, -3, 6, 17, 22, 24, 26, 27, 27, 27, 28, -24, -22, -15, -7, -3, 3, 7, 12, 26, 33, 35, 35, 25, 17, 8, -15, -41, -57, -57, -57, -57, -57, -43, -25, 3, 30, 50, 66, 82, 83, 83, 76, 48, 25, 3, -27, -49, -64, -75, -75, -73, -61, -42, -21, -1, 16, 29, 37, 40, 41, 41, 34, 28, 11, -3, -8, -10, -11, -11, -12, -13, -12, 0, 2, 2, 70, 53, 44, 43, 31, -3, -14, -49, -54, -73, -73, -72, -64, -31, 14, 58, 82, 89, 97, 96, 81, 59, -12, -52, -86, -99, -115, -116, -111, -78, -29, 21, 74, 84, 113, 114, 114, 111, 53, 17, -30, -72, -110, -113, -111, -101, -68, -28, 19, 59, 80, 89, 91, 91, 74, 25, -24, -24, -45, -61, -68, -67, -43, -6, 79, 29, 21, 19, 13, 8, 8, -11, -27, -36, -35, -34, -29, -9, 24, 48, 63, 62, 57, 27, 5, -27, -48, -70, -70, -67, -41, -4, 22, 62, 78, 84, 82, 49, 3, -40, -62, -84, -84, -71, -38, 2, 37, 71, 70, 69, 56, 37, 7, -26, -48, -59, -58, -53, -27, -2, 22, 42, 46, 41, 24, 14, -5, -14, -21, -37, 14, 3, -8, -26, -24, -24, -7, 14, 26, 40, 40, 36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
