INITRAMFS-AUC/KWS-SoC/(commit log)

2025-11-19 Working assembly example
2025-11-21 hellow world on uart
2026-02-02 FPGA Compatability Makefile Target and Source Code Fixes
    [kws_soc.v]
2026-02-05 Mv configs to file
    [picodriver.cfg, sim.cfg]
2026-02-11 fixed picodriver syntax error
    [picodriver.cfg]
2026-02-11 Define UART values in makefile
2026-02-11 UART div caclulated from CLK
2026-02-11 Fix UART sim
2026-02-11 Error on no Baud Rate
    [hello_world.c]
2026-02-15 Integrate flash controller into KWS SoC, expose external flash interface
    - Added AHB flash controller (XIP) to KWS SoC, exposing interface signals (flash_csn, flash_sck, flash_doe, flash_do, flash_di) for connection to an external flash device.
    - Updated soc.f to include flash controller HDL files (ahbl_flash_ctrl_eb_cache.v, flash_ctrl_eb.v, ro_cache.v), but did NOT add the actual flash model (sst26wf080b.v) since it is non-synthesizable and not suitable for CXXRTL simulation.
    - Developed C test (test/xip/c/flash_read_test.c) to verify flash read functionality. This test will only work as intended when the SoC is connected to a simulated or real external flash module.
    - Note: In simulation,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
2026-02-17 Fix booting to start at FLASH base address. New Error: 1-byte offset of instruction read at haddr
    [kws_soc.v]
2026-03-02 Fix address map of splitter
    Old configuration ignored 0x8
    [kws_soc.v]
2026-03-02 Change Failed Flash command to warning
    [flashsim.cpp]
2026-03-02 Switch breakpoints to hbreak
    [sim.cfg]
2026-03-02 Fix config piping into top module yosys lint
    [kws_soc.v]
2026-03-02 set FPGA GPIO pins to 3.3V
2026-03-02 Update GPIO to 3.3 V
2026-03-16 Fixed XIP (waiting for fpga)
    [ahbl_flash_ctrl_eb_cache.v, ahbl_flash_ctrl_eb_cache_tb.v, flash_ctrl_eb.v, kws_soc.v]
2026-03-17 xip: fixed and clean flash crtl
    [flash_ctrl_eb.v, ro_cache.v]
2026-03-18 xip: param typo fixed
    [flash_ctrl_eb.v]
2026-03-18 Makefile: refactor and multi user
    [sim.cfg]
2026-03-18 soc_test/c/Makefile fix, i2s integration in kws_soc.v
    [kws_soc.v]
2026-04-02 soc: make timer and uart use rst_n_cpu
2026-04-04 VPI sim for faster simulation than cxxrtl
    [sim.cfg]
2026-04-11 carriage return to readI2s.c
2026-04-14 Bus matrix and 2 port (#18)
    * soc: switch to crossbar
    * soc: switch to 2 port
2026-04-16 Define global printf function for all tests
2026-04-19 Switch model code linking from ld to gcc to resolve compiler helper symbols (e.g., divsi3, mulsi3, etc) via libgcc; build now advances to remaining undefined memset
    [strided_s16_nodil_weights.h]
2026-04-20 init integration, and fixes
    [dma_test.c, kws_soc.v]
2026-04-20 implement format specifiers for printf
2026-04-20 Pin nnom submodule to 733d72b
2026-04-20 tb: fix wire naming
    [ahbl_flash_ctrl_eb_cache_tb.v, flash_ctrl_eb_tb.v]
2026-04-21 added pirq test case
2026-04-21 fixed gdb halting
    [sim.cfg]
2026-04-22 openocd: switch to latest syntax req
    [picodriver.cfg, sim.cfg]
2026-04-23 switch to pp dma module
2026-04-23 jtag: speed up to avoid timeouts
    [picodriver.cfg]
2026-04-24 DMA - I2S transfers
2026-04-25 scripts: add warning and uart script
2026-04-25 pirq DMA half-fix
2026-04-25 Replace streaming test harness with bare-metal I2S firmware
    Swap streaming_b_main.c (fopen accuracy test) for kws_bare_stream.c
    (I2S ISR firmware). kws_bare_stream.c is the direct replacement for
    kws_bare.c — same I2S/UART/CSR register layout, same DETECT: UART
    output, but uses kws_stream_b_push() instead of model_run().
    Verified 6/6 on Spike: yes/no/go/stop/left/down all detected correctly.
    Compile with I2S_FIFO_DEPTH=8 for real SoC hardware.
    [kws_bare_stream.c]
2026-04-25 Add mel_compact_4blk_ch36 bare-metal firmware under test/mel_compact
    88.7% accuracy, 31 KB flash binary, 53 KB SRAM — fits comfortably in
    128 KB SoC SRAM (vs strided_s16_nodil at 85 KB flash / 278 KB SRAM).
    Files:
    kws_bare.c — I2S/UART bare-metal firmware
    mel_compact_4blk_ch36_weights.h — NNoM int8 weights (28.7 KB)
    Build: same flags as strided_s16_nodil kws_bare, just swap -I and weights.
    [kws_bare.c]
2026-04-26 dma submodule i2s half-fix
2026-04-26 DMA firmware fix
2026-04-27 hazard3: advance to upstream HEAD; adapt SoC for new param/port set
    Bumps the Hazard3 submodule from our long-stale fork commit (7949618) to
    upstream Wren6991/Hazard3 HEAD (8af9929, v1.1.1, Mar 2026). 14 months of
    upstream changes, mostly large rewrites of hazard3_core.v / hazard3_csr.v /
    hazard3_decode.v / hazard3_frontend.v.
    The fork's HDL patches were either inactive (commented-out uop_ctr generate
    block in hazard3_instr_decompress.v hits dead code under EXTENSION_ZCMP=0;
    broken tick_nrz wire in hazard3_riscv_timer.v hits dead code under the
    default TICK_IS_NRZ=0) or trivially benign (a stray `;;` cosmetic fix in
    libfpga's ahb_cache_writeback.v). None were necessary for our SoC.
    Adapt t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
    [kws_soc.v]
2026-04-27 busfabric: replace local copies with upstream libfpga/busfabric/*
    Our busfabric/ was a stripped-down local copy of libfpga's bus fabric:
    - AHB5 atomics ports (hexcl, hexokay, hmaster) removed across the
    arbiter / splitter / crossbar
    - IGNORE_BUS_ERRORS parameter removed from splitter
    - FAIR_ARBITRATION parameter removed from arbiter
    - ahbl_to_apb.v had a different state machine (10 states with explicit
    S_RD2 / S_WR3 instead of upstream's 8-state version with S_READY)
    Sync with upstream libfpga's versions (now at 964ceca via the Hazard3
    submodule bump). The kws_soc.v wiring adapts in this commit too:
    - crossbar instantiation gets the new src_hexokay, src_hmaster, src_hexcl
    inputs and d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
    [ahbl_arbiter.v]
2026-04-27 test: add bridge_bug_test firmware for the 2-port d-port→bridge race
    Reproducer for the FPGA-only corruption bug described in
    docs/2port_dport_bridge_bug.md. Emits:
    55 55 55 55 — sync header (clean_write)
    00 01 02 ... ff — 256 bytes via the buggy LBU c → SW UART_TX = c
    pattern (matches gcc's emit for `uart_putc(c)`-
    style functions where data comes off the stack)
    aa aa aa aa — end-of-round marker (clean_write)
    On a working build the receiver gets the full 0x00..0xFF range back. On a
    broken build (race fires) the middle 256 bytes all come out as 0xD0 — the
    LBU's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
    [bridge_bug_test.c]
2026-04-27 docs: 2-port d-port → APB bridge corruption (investigation log)
    Capture the full diagnostic trail for the FPGA-only bug where a tight
    LBU c → SW UART_TX = c sequence after a heavy d-port loop corrupts every
    byte sent to the UART to 0xD0 (= the frame pointer s0's low byte). Bug
    exists in upstream Hazard3 too; manifests only on FPGA, never in
    Verilator. Documents:
    - the test taxonomy (Tests A through Q') that narrowed it to the load →
    store-data path in hazard3_core.v
    - the smoking-gun byte value 0xD0 = s0[7:0] = LBU's xm_result (address)
    leaking through the M-stage bypass fallback when the bypass condition
    xm_rs2 == mw_rd evaluates to false on FPGA
    - why Verilator hides it (ideal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
2026-04-27 working-fpga: patch hazard3_core to stall load→store-data RAW
    Workaround for the FPGA-only race documented in
    docs/2port_dport_bridge_bug.md. The upstream optimisation in
    hazard3_core.v skips the load-use stall when the consumer is a store
    and relies on M-stage `mw_result` forwarding. On our 2-port CPU + APB
    bridge, that forwarding loses a race on FPGA: `mw_rd` doesn't latch in
    time, the bypass condition `xm_rs2 == mw_rd` evaluates to false, and
    `m_wdata` falls through to `xm_result` — which for a load is the load's
    ADDRESS, not its data. The store ends up writing the load's address to
    the bridge.
    Patch deliberately removes the store exception so a tight LBU→SW-data
    sequence stalls on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
2026-04-27 debug-snooper: APB-readable bus snooper with CPU M-stage taps
    New peripheral at 0x4000_C000 that captures every AHB-bridge transaction
    together with the CPU's M-stage forwarding state. Built to confirm the
    2-port d-port → APB-bridge HWDATA corruption documented in
    docs/2port_dport_bridge_bug.md, by recording the exact moment when
    m_wdata diverges from xm_result/mw_result during a tight LBU→SW.
    Pieces:
    * peris/snooper/bus_snooper.v
    APB slave + 16-entry ring buffer. Latches addr/control in aphase,
    commits on dphase end alongside bridge_hwdata and the CPU taps
    (xm_rs2, mw_rd, xm_result, mw_result, m_wdata). 8 words per entry;
    CSRs (CTRL / STAT / CYCLE / RESET) at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
    [bus_snooper.v, kws_soc.v]
2026-04-27 test: snooper_test firmware exercising the bus snooper
    Mirrors bridge_bug_test's clean_write / buggy_write helpers, but with the
    ring buffer armed in between so each bridge transaction is captured
    together with the CPU M-stage forwarding state.
    Sequence:
    1. uart_init (DIV / CSR writes happen before the snooper is enabled,
    so they don't burn ring slots).
    2. SNOOP_RESET = 1; SNOOP_CTRL = 1;
    3. Eight alternating clean_write(0x55) / buggy_write(0x42) calls.
    4. SNOOP_CTRL = 0; ebreak.
    Read out from GDB after the ebreak (32 bytes per entry, 16 entries):
    x/8wx 0x4000C000 # entry 0 (cycle, addr_ctrl, hwdata, m_wdata,
    # {mw_rd,xm_rs2}, xm_result, m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
    [snooper_test.c]
2026-04-27 scripts: GDB helper to pretty-print the bus_snooper ring
    After snooper_test ebreaks, source the script and run dump_snooper to
    get a one-line-per-entry table of every captured bridge transaction
    alongside the CPU's M-stage taps. Entries where bridge_hwdata's low byte
    diverges from m_wdata's low byte get a "HWDATA != M_WDATA" annotation —
    the d-port → APB-bridge corruption the snooper exists to catch.
    Use:
    (gdb) source scripts/dump_snooper.gdb
    (gdb) dump_snooper
2026-04-27 debug-snooper: tap CPU d-port aphase to split routing vs CPU bug
    Adds dport_haddr / dport_hwrite / dport_htrans inputs to bus_snooper
    and wires them from the CPU 2-port wrapper outputs (between
    hazard3_cpu_2port and the crossbar input). Captured in the same aphase
    as the bridge taps, so a misroute (CPU emits address X, crossbar drives
    the bridge with a different address) is visible directly:
    - bridge_haddr != dport_haddr[15:0] → fabric routing bug
    - bridge_haddr == dport_haddr[15:0] → CPU emitted the wrong haddr
    itself (CPU bug)
    Ring layout updated: the previously reserved word at +0x1C now holds
    dport_haddr[31:0]; +0x04 packs the dp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
    [bus_snooper.v, kws_soc.v]
2026-04-27 debug-snooper: add aph_req / xm_memop / m_bus_stall taps
    Three more taps from hazard3_core to test the early-aphase hypothesis
    behind the back-to-back UART_TX writes the snooper caught (entries
    1/4/7/10 vs 2/5/8/11 — same address, 2 cycles apart, different data):
    - dbg_bus_aph_req_d : core's "I want an aphase now" signal
    - dbg_xm_memop[4:0] : what the M-stage thinks it's doing
    (5'h05 SW, 5'h0a SH, 5'h0b SB, 5'h04 LBU,
    5'h10 NONE)
    - dbg_m_bus_stall : M-stage held by an in-flight bus dphase
    Threaded through hazard3_cpu_2port (and 1port for lint cleanliness),
    captured in the same aphase pending-snapshot as the dport_* taps,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
2026-04-27 ASIC .saif targets and flow
2026-04-27 test: snooper_test now self-dumps the ring over UART
    Adds a UART hex dump after the test, so the same firmware can be run in
    both Verilator and on FPGA and the snooper captures compared
    byte-for-byte. This was triggered by the open question of why the
    2-port d-port → bridge double-aphase symptom appears on FPGA but
    (allegedly) doesn't reproduce in Verilator, given identical RTL and the
    same snooper.
    Output format:
    BEGIN\r\n (banner — confirms UART works)
    SNOOP\r\n
    16 lines, each: 64 hex chars (8 words * 8 hex digits) + CRLF
    END\r\n
    ebreak
    The dump uses uart_putc_safe(), which (a) FSTAT-polls — pure loads, no
    LBU→SW pattern — then (b) issu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
    [snooper_test.c]
2026-04-27 test: build snooper_test_xip.bin for Verilator FLASH= path
    Verilator's sim path loads firmware from flash, so the XIP-linked
    binary is what we need to run snooper_test in simulation. SRAM build is
    unchanged (still used for the JTAG/GDB workflow on FPGA).
    The XIP and SRAM builds share the same .o for snooper_test, so the
    buggy_write LBU→SW pattern at offset 0x40 from the function start is
    identical in both — only text/rodata VMA differs (0x8000_0000 in XIP,
    0x0000_0000 in SRAM). D-port traffic (stack accesses to SRAM, UART
    writes to bridge) is unchanged.
2026-04-27 debug-snooper: optional 1-cycle SRAM read wait state for sim repro
    The first sim/FPGA comparison via snooper_test confirmed the duplicate
    UART_TX aphase is FPGA-specific — Verilator shows 8 ring entries (4
    clean + 4 buggy, all correct), FPGA shows 12 (the extra 4 are spurious
    mid-buggy_write transactions writing 0xD0 to UART_TX).
    Hypothesis: Cyclone V M10K has more read-port latency than the
    behavioural sram_sync's `always @(posedge clk) rdata <= mem[addr]`,
    keeping the LBU's M-stage stalled an extra cycle, which keeps
    core_aph_req_d high for an extra cycle, which lets the bridge sample
    NSEQ twice for the SW@1c4. This patch tests that hypothesis by adding
    an EXTRA_RD_WAIT parameter to ahb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
    [kws_soc.v]
2026-04-29 debug-snooper: fix — gate bus_aph_req_d after acceptance
    Adds the smallest fix that suppresses the FPGA-only "duplicate UART_TX
    aphase" symptom. Lives in the same patch file as the debug taps
    (both modify hdl/hazard3_core.v); commit it separately so the fix
    itself is reviewable as one change.
    The bug, in short: when the M-stage stalls (m_stall=1) for any reason
    — multi-cycle bridge dphase, M10K read latency the behavioural
    sram_sync doesn't model — the X-stage holds, but bus_aph_req_d (and
    therefore d_htrans=NSEQ) stays asserted across multiple hready=1
    boundaries. The AHB→APB bridge in this SoC samples NSEQ each time it
    returns to S_READY, producing two transactions for one SW. The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
2026-04-29 debug-snooper: document findings, drop failed fix, gate wait state off
    Closes out the snooper investigation:
    * Removes the x_aph_done gating from patches/debug-snooper-hazard3_taps.patch.
    The fix never latched in the failing scenario (x_stall already includes
    "bus_aph_req_d && !bus_aph_ready_d", so !x_stall goes high the same cycle
    bus_aph_ready_d does, and the reset branch beats the set branch). Re-running
    snooper_test in sim with both EXTRA_RD_WAIT=1 and the gate applied gave
    byte-identical output to "wait state on, no fix" — confirmed dead code.
    Keep the debug taps (dbg_xm_rs2, dbg_mw_rd, dbg_xm_result, dbg_mw_result,
    dbg_m_wdata, dbg_bus_aph_req_d, dbg_xm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
    [kws_soc.v]
2026-04-30 test: unify KWS firmware in test/common/kws_bare_main.c
    Both NNoM model variants (strided_s16_nodil, mel_compact_4blk_ch36)
    now build from one shared source so cycle counts compare apples-to-
    apples. Per-model knobs are passed via -D in test/Makefile:
    -DKWS_WEIGHTS_HEADER='"<header>.h"' model weights blob
    -DKWS_MODEL_NAME='"<name>"' UART banner string
    -DNNOM_STATIC_BUF_KB=<kb> activation peak (no default —
    the file errors out if absent)
    Also:
    - I2S_CLK_DIV default set to 70 (36 MHz FPGA → 8 kHz mono).
    - Mcycle CSR cycle measurement is now opt-in via -DUSE_MCYCLE_CSR.
    It's off by default — the Verilator/CXX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
    [kws_bare_main.c]
2026-04-30 test: bare-metal model link, drop libc + libgcc
    The model build had `-nostartfiles -lm -lgcc` which dropped only crt0
    and still pulled in newlib's libc / libgloss. That linked the bigger
    of two evils (full newlib, weak ecall syscall stubs) and forced us to
    ship test/common/sbrk.c just to satisfy _sbrk / _write / _exit / etc.
    None of those are reachable in our int8 NNoM build (NNoM_USING_STATIC
    _MEMORY routes nnom_malloc, NNOM_LOG is suppressed, no FP layers).
    Switch to a real freestanding link:
    -nostdlib (== -nostartfiles + -nodefaultlibs). No libc, no libgcc.
    No -lm: confirmed via grep that no NNoM unit we compile calls into
    libm — int8 softmax is a LUT, no sqrt/exp/etc.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
2026-04-30 test: add ring_buf vs input-hex diff harness
    Diagnostic for the inference regression vs commit 54d3329 (CPU-driven
    FIFO read in the trap handler) — same model + same audio now predicts
    wrong with the DMA + dmac_irq path. Hypothesis: the DMA / ISR pipeline
    is delivering different bytes into ring_buf than i2s_mic_sim actually
    fed in. Prove it directly by dumping ring_buf at run-time and diffing
    against the input hex.
    test/common/kws_bare_main.c:
    -DKWS_DEBUG_DUMP_FIRST_CLIP inserts an ebreak after the FIRST full
    ring_buf is captured and before memcpy / inference, so GDB can
    inspect ring_buf without stale or in-flight DMA writes.
    scripts/dump_ring_buf.gdb:
    Re-emits each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
    [kws_bare_main.c]
2026-04-30 test: Makefile knobs for KWS_DEBUG_DUMP_FIRST_CLIP / USE_MCYCLE_CSR
    Append `STRIDED_CFLAGS+=-D…` on the make command line replaces the
    variable instead of extending it (command-line vars override Makefile
    ones), so the in-source -D flags become invisible. Surface the two
    optional knobs explicitly so:
    make -C test KWS_DEBUG_DUMP_FIRST_CLIP=1 model-strided-s16-nodil
    inserts the diagnostic ebreak without breaking the include paths or
    the per-model -DKWS_WEIGHTS_HEADER / -DNNOM_STATIC_BUF_KB.
2026-04-30 Hazard3: bump submodule to 8af9929 (v1.1.1) to match merged kws_soc.v
    The merge commit for `main` into NNOM-DMA-MUL_DIV_UNROLL accidentally
    kept the old branch's Hazard3 SHA (7949618) instead of main's
    (8af9929) when resolving the submodule-pointer conflict. But the
    kws_soc.v body that came in from that same merge is wired against
    8af9929's CPU interface:
    - MIMPID_VAL / MHARTID_VAL moved from parameters to input ports
    (mhartid_val, eco_version) → kws_soc.v passes them as ports.
    - New fence_i_vld / fence_d_vld / fence_rdy ports → kws_soc
    ties fence_rdy=1 and leaves the *_vld outputs unused.
    7949618 has none of those ports and still treats MIMPID_VAL /
    MHARTID_VAL a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
2026-04-30 test: make ring_buf-dump diagnostic actually work in GDB
    Three issues from the first run:
    1. No DWARF symbols. MODEL_CFLAGS didn't carry -g, so GDB couldn't
    even type-check ring_pos. Add -g unconditionally — `objcopy -O
    binary` strips .debug_* anyway, so the .bin we ship to flash and
    the binary size we measure stay identical. Cost is purely on-disk
    ELF (≈45 KB → ≈220 KB) and developer-side.
    2. -flto + static volatile globals = "<optimized out>". Even with
    -g, LTO drops DWARF location info for the static volatiles in
    kws_bare_main.c (ring_buf / ring_pos / i2s_irq_count); their
    storage exists per `nm` but GDB refuses `&ring_buf[0]`. When
    KWS_DEBUG_DUMP_FI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
2026-04-30 test: switch ring_buf diagnostic from GDB dump to UART dump
    The GDB-based dump (scripts/dump_ring_buf.gdb) ran into two problems
    the way it was set up:
    - Even with -g and __attribute__((used)) on the static volatiles,
    LTO still marks ring_buf / i2s_irq_count as <optimized out> in
    DWARF, so `&ring_buf[0]` from the GDB script fails.
    - Disabling LTO to fix DWARF visibility (-fno-lto in the diagnostic
    CFLAGS) actually broke the firmware at runtime — execution hangs
    after the boot banner before "Model loaded" prints, somewhere in
    nnom_model_create's layer-setup chain. Symptom: 200M+ sim cycles
    past the banner and the ebreak is never reached. Keeping LTO is
    the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
    [kws_bare_main.c]
2026-04-30 sim: heartbeat goes to stderr, keep stdout clean for UART byte stream
    The Verilator testbench prints both:
    - the simulated UART byte stream (firmware -> putchar(ch) -> stdout)
    - a 10M-cycle heartbeat ("[Sim] Cycle ... uart_tx=...")
    to the same stdout, so they interleave. When the firmware dumps the
    ring_buf as hex words (KWS_DEBUG_DUMP_FIRST_CLIP=1), the heartbeat
    lines splice into the middle of UART words and the dump-extraction
    pipeline drops every line that got bisected (~1 line lost per heartbeat
    during the dump, ~30 of 8000 today).
    Move the heartbeat to stderr. No effect on previously-clean runs;
    diagnostic captures (`./Vkws_soc ... | tee uart.log`) now hold a clean
    UART stream a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
2026-04-30 test: align DMA burst (4 words) with I2S half-full threshold
    The diagnostic dump (KWS_DEBUG_DUMP_FIRST_CLIP=1) reproduced the
    inference regression: in sim/down_0000.hex the first 2132 samples
    are silence (all 0x00000000), and ring_dump.hex matched there;
    but starting at sample 2133 — the first non-zero sample — the
    dump began losing samples in clusters (1, 1, 1, 12, 1, 8, 10 ...).
    Root cause:
    hardware FIFO_DEPTH = 8 (kws_soc.v)
    hardware i2s_irq threshold = FIFO/2 = 4 samples
    firmware DMA burst (I2S_FIFO_DEPTH)= 8 transfers
    ⇒ each PIRQ fires at fifo_count >= 4, DMA does 8 reads. First
    4 pop real samples, last 4 read fifo_empty -> 0x00000000.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
2026-04-30 i2s: single source of truth for FIFO depth + DMA burst (now 16/8)
    The I2S receiver's hardware FIFO depth (apb_i2s_receiver's FIFO_DEPTH
    parameter, sets the half-full IRQ threshold to N/2) and the firmware
    DMA burst (formerly -DI2S_FIFO_DEPTH=4) used to live in two unrelated
    files with no enforced link. When they drift, every other 4-block in
    ring_buf is silently zero-padded by FIFO-empty reads — the regression
    we just hunted down.
    Cohere the two by deriving both from one knob in the root Makefile
    (see todo task #13). Until task #12 (autonomous DMA drain) lands
    this constraint can't be expressed in hardware; the build does it for
    us instead.
    Makefile : I2S_FIFO_DEPT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
    [kws_bare_main.c, kws_soc.v]
2026-04-30 test/common: word-aligned memcpy/memset for the bare-metal model link
    GCC emits memcpy/memset libcalls for any non-trivial copy/fill, and
    NNoM moves a lot of bytes per inference: each Conv2D layer's im2col
    and padding loops in nnom_local.c push ~MB-scale data through
    nnom_memcpy / nnom_memset. For mel_compact_4blk_ch36 (4 conv blocks,
    ~36-channel feature maps) that's roughly 9 MB of memcpy and a comparable
    amount of memset PER inference.
    The previous byte-at-a-time implementations were ~4x slower than what
    they replaced (newlib libgcc memcpy was word-aligned), accounting for
    ~30M of the 60M cycle regression vs the pre-merge 130M baseline.
    Strategy is the standard "byte-prefix until aligne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
    [memcpy.c, memset.c]
2026-04-30 test: canonical NNoM integration + local nnom_port.h override
    Two related changes that share the -I path reordering:
    1. Compile every src/**/*.c file in third_party/nnom, not the 18 we
    previously hand-picked. Per upstream NNoM README ("Accessing C
    files"): "add inc/ and port/ as include directories, and compile
    the src/*.c files". --gc-sections drops the layer implementations
    the active model doesn't reach, so we pay nothing at runtime for
    the LSTM/GRU/lambda/concat/dw_conv2d/sumpool/upsample/zero_padding
    bodies. Verified with `objdump`: text size is unchanged at 28836 B
    for mel_compact (gc-sections strips them cleanly, including the
    raw printf calls inside nnom_l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
    [nnom_port.h]
2026-04-30 Revert "test/common: word-aligned memcpy/memset for the bare-metal model link"
    Measured: byte-loop versions are ~20M cycles FASTER than the word-aligned
    implementation on mel inference (190M vs 210M). Counter-intuitive but
    consistent across runs.
    Likely cause: at -Os -flto the byte loop is 42 bytes / ~10 instructions
    with one inner branch, simple enough for GCC's auto-vectorizer + branch
    predictor friendliness on Hazard3. The word version is 80+ bytes with
    ~5 prologue branches (alignment check, source-aligned check, fall-through
    paths) plus a post-loop `mul a4, a4, -4` for pointer fixup; per-call
    overhead (mispredicts + mul latency) exceeds the savings on the inner
    loop for the typical sm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
    [memcpy.c, memset.c]
2026-04-30 flake: prefer local /opt/riscv/gcc14-no-zcmp toolchain when present
    The Nix-shipped riscv32-none-elf toolchain is GCC 13.3 built with
    `--disable-multilib` — only one libgcc.a, compiled `ilp32d` (hard-
    float ABI). Linking that against our soft-float (`-mabi=ilp32`)
    firmware forces an ABI dance and produces NNoM inference cycle counts
    that don't match the original 130M mel baseline measured on the
    canonical multilib GCC-14 toolchain at /opt/riscv/gcc14-no-zcmp.
    Have the dev shell prepend that path to $PATH if the toolchain is
    installed; fall back to Nix otherwise. Print which one is active in
    the shell banner so it's obvious which toolchain a measurement used.
    This is the lowest-friction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
2026-04-30 nix/riscv-toolchain: assemble from per-component fetches, identical to local recipe
    The fetchSubmodules=true approach failed because the meta-repo's
    .gitmodules pins one of its 12 submodules (dejagnu) at a commit
    git.savannah.gnu.org refuses to direct-fetch. Even though we don't
    need dejagnu (it's only for testsuite runs), fetchSubmodules is all-
    or-nothing.
    Switch to component-level pinning: read the meta-repo's tree at tag
    2024.12.16 via GitHub's API, get the gitlink SHAs for binutils and
    newlib, fetch each from the same upstream URL the meta-repo's
    .gitmodules declares (sourceware.org). No mirrors, no rewrites — the
    exact same bytes the local `make` would have pulled via
    `git submodu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
2026-04-30 nix/riscv-openocd: pin to concrete SHA, not the bare branch name
    `rev = "riscv"` was being interpreted by fetchFromGitHub as
    `refs/tags/riscv` — that tag doesn't exist on github.com/riscv/riscv-openocd
    so the fetch failed with "couldn't find remote ref refs/tags/riscv".
    Bare branch names need to either be `refs/heads/<name>` or a concrete
    SHA; concrete SHA is the reproducible choice.
    Pinned to the tip of the `riscv` branch as of 2025-10-09 (the closest
    prefetch could resolve when this commit landed). Document the
    re-prefetch incantation alongside.
2026-04-30 nix/riscv-toolchain: disable -Werror=format-security for the build
    Nix's stdenv enables -Werror=format-security by default. Compiling
    GCC 14's libcpp/expr.cc and libcpp/macro.cc as part of the
    bootstrap-gcc-stage1 phase trips that flag on legitimate
    `fmt = "string-with-no-args"` calls inside the preprocessor source —
    those source files are upstream GCC, we can't patch them.
    Add `hardeningDisable = [ "format" ];` to the derivation. Other
    hardening flags (stackprotector, fortify, pie, etc.) stay on, so we
    only relax the one flag the GCC source actually trips.
2026-04-30 test: report capture / infer / total cycles per clip
    The mcycle CSR brackets around model_run() only — what we labelled
    CYCLES: today. But every inference window also pays an audio-capture
    cost: the CPU is in WFI for the duration of one clip's I2S sample
    stream (~72M cycles at I2S_CLK_DIV=70 / 36 MHz / 8000 samples), the
    SoC clock + I2S peripheral + DMA controller + bus stay live. That's
    real energy and real real-time latency we want to track.
    Add a second mcycle bracket around the WFI-until-ring_ready window
    and emit three lines per clip when USE_MCYCLE_CSR=1:
    CYCLES_CAPTURE: I2S + DMA + ISR fill cycles (constant per cfg_div)
    CYCLES_INFER: model_run() only
    CYCLES_TOTAL: capt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
2026-05-01 nix/riscv-toolchain: pin gcc to 2025-11-15 commit (matches /opt/riscv build)
    The local /opt/riscv/gcc14-no-zcmp was built on 2025-11-15
    ("gcc version 14.3.1 20251115"). We were pinning gcc to commit
    ed10445 from 2024-05-07 — six months earlier on the same branch.
    Optimizer changes between gcc 14.1 and 14.3 produced a measurable
    inference cycle delta:
    Local /opt/riscv (gcc 14.3, 2025-11-15): CYCLES_INFER 118,602,556
    Nix (gcc 14.1, 2024-05-07): CYCLES_INFER 108,271,212
    Different by 10M cycles — toolchain drift, not a real cycle change.
    Pin gcc-rev to 399c8b359d8ed160757b20374bc8ccdbcf0fbb92 — the branch
    tip of releases/gcc-14 on 2025-11-15 00:27:42 UTC ("Daily bump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
2026-05-01 nix/riscv-toolchain: pin all sources to 2025-11-15 (matches /opt/riscv)
    The local /opt/riscv/gcc14-no-zcmp was built on 2025-11-15 from a
    fresh `git clone` of the meta-repo (no specific tag/rev) plus a
    fresh `git clone --depth=1 -b releases/gcc-14`. Both commands grab
    HEAD on the day they run, so the local binary's source set is:
    riscv-gnu-toolchain master HEAD on 2025-11-15 (last commit
    2025-11-03)
    binutils submodule whatever the meta-repo's gitlink at that
    commit pinned (resolved via GitHub trees API)
    newlib submodule same
    gdb submodule same
    gcc releases/gcc-14 HEAD o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
2026-05-01 test: I2S_CLK_DIV 70 -> 35 (8 kHz capture, was running at 4 kHz)
    apb_i2s_receiver toggles SCK every (cfg_div + 1) system cycles, so
    the SCK PERIOD is 2 * (cfg_div + 1) cycles, not (cfg_div + 1). An
    earlier comment in the firmware had
    36M / (8000 * 32 * 2) = 70
    which forgot the 2× for the SCK half-period. At cfg_div=70 the
    actual sample rate was
    36e6 / (128 * 71) = 3961 Hz (~4 kHz)
    so 8000 samples = 2 seconds of sim time = 72M cycles for one clip.
    That's exactly what we measured (CYCLES_CAPTURE = 72,659,468) and
    why first-clip CYCLES_TOTAL was 50M too high vs the team's 130M
    historical reference.
    Correct formula:
    sample_rate = clk / (128 * (cfg_div + 1))
    cfg_div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
    [kws_bare_main.c]
2026-05-01 docs: add TODO.md, ignore root-level sim/debug logs
    Persistent project todo list at docs/TODO.md, ranked by priority
    (P0 correctness → P3 dev velocity). Source of truth for in-flight
    work — anything tracked in the harness's task list also lives here
    so nothing is lost across sessions.
    .gitignore: anchor /*.log, /ring_dump.hex, /testres.hex to the project
    root so ad-hoc test captures don't pollute git status while leaving
    intentional logs/hex inside test/ and sim/ alone.
2026-05-01 scripts/apply_patches: gate working-fpga patch behind FPGA_PATCHES=1
    The working-fpga-hazard3_core.patch is FPGA-only — it forces an
    extra RAW stall to suppress the d-port→APB-bridge HWDATA corruption
    documented in docs/2port_dport_bridge_bug.md. Verified empirically
    to cost 0 cycles on Verilator (sim doesn't reproduce the FPGA
    race), so applying it on sim is pure cleanliness regression: the
    Hazard3 submodule shows up as `m Hazard3` in `git status` after
    every build because the working tree has the patch applied while
    the committed submodule SHA doesn't.
    Same pattern as the existing DEBUG_SNOOPER gating: skip the patch
    in apply mode when FPGA_PATCHES isn't set (also accepts FPGA=1 for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
2026-05-01 docs/TODO: defer ring_buf overflow, promote I2S NNoM merge
    ring_buf overflow (#16) is moot once the team's Conv1D accelerator
    lands — once inference fits inside one capture window the gap closes
    naturally. Move it to a "deferred (waiting on external dep)" section
    so it stays visible without crowding P0.
    Promote the peris/i2s nnom-quantize merge (#19) to top of P1 — it
    both shrinks capture-leg bus traffic 4× and removes the firmware
    `>>16` Q7 extraction in the ISR, and it's the work the team is
    asking for next. VAD (#18), autonomous DMA drain (#12), and FIFO-
    empty power-gate (#17) follow.
2026-05-02 i2s+kws: Q8_EN packing path, hoisted ISR bounds check (Phase A of #19)
    Bumps peris/i2s submodule to ae635b0 ("down-sampling and HW-int8
    quant"), which adds CONF_DS_EN (bit 5) and CONF_Q8_EN (bit 6) to
    apb_i2s_receiver. With Q8_EN the FIFO stores four packed int8
    samples per 32-bit word (byte[3]=oldest, byte[0]=newest), so the
    capture-leg traffic from I2S → DMA → ISR drops 4×.
    Firmware adaptation in kws_bare_main.c:
    * I2S_CONF_* macros for the new bits and a documented i2s_init
    that turns on Q8_EN | SKIP_R_EN | IRQ_EN (DS_EN deliberately
    off — would halve audio rate to 4 kHz).
    * Trap handler unpacks 4 samples per dma_batch word MSB-first to
    preserve audio time order i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
    [kws_bare_main.c]
2026-05-02 test: merge readI2s.c Q8 testbench from origin/NNOM, propagate burst macro
    readI2s.c was a 1-line FIFO-print smoke test on this branch. The
    NNOM branch carries a proper Q8 testbench: a hex pattern table from
    sim/debug_audio.hex (with two warmup zeros for the phantom WS frames
    the I2S clock generator produces before the simulator drives data),
    a configure helper that takes ds_en / q8_en explicitly, and an ISR
    that compares each HW-packed byte to the firmware-equivalent
    extraction (raw[23:16]) and tallies PASS/FAIL. Switched the hard-
    coded `I2S_FIFO_DEPTH 8` to `I2S_DMA_BURST_WORDS` so it tracks the
    half-full threshold derived from the root Makefile.
    test/Makefile:
    * Move the I2S_FIFO_DE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
    [readI2s.c]
2026-05-02 docs/TODO: capture audit findings, add Option 1 / Option 2 audio path
    Audit of the I2S → DMA → ring_buf → model_input pipeline (2026-05-02)
    found two architectural improvements worth recording:
    Option 1 — DMA directly into nnom_input_data + LSB-oldest Q8 pack
    order (one-line RTL change in apb_i2s_receiver.v). Eliminates
    ring_buf, dma_batch, the per-IRQ byte-unpack, and the end-of-clip
    memcpy. Saves ~66K cycles/clip and 8 KB SRAM but doesn't reduce
    the 250 IRQs/clip (the DMA's CNTR resets between frames so DADDR
    must advance per frame).
    Option 2 — make apb_i2s_receiver an AHB master that drains the
    FIFO straight into a SRAM ring with no DMA peripheral involved.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
2026-05-02 i2s+kws: Option 1 — wrap-around audio_ring + lean ISR + LSB-oldest Q8
    Bumps peris/i2s to a8c0285 (q8-lsb-oldest branch) and rewrites the
    kws bare-metal firmware to consume the new pack order.
    RTL (peris/i2s @ a8c0285):
    apb_i2s_receiver Q8 commit now writes
    fifo[wr_idx] <= {newest_byte, pack_reg[7:0], pack_reg[15:8],
    pack_reg[23:16]}
    so byte0 (oldest) lands at the FIFO word's LSB. On a little-endian
    RV32 host an APB read or DMA write of that word puts the bytes in
    TIME order at the destination address — no firmware-side
    byte-shuffle needed.
    Firmware (test/common/kws_bare_main.c):
    * audio_ring[8192] aligned(4) — separate from nnom_input_data. The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
2026-05-02 build: hazard3_config.vh as single source of truth for RV ISA + extensions
    Resolves TODO #6 (CLK_MHZ / UART_BAUD_RATE pipe) and #13 (single
    source of truth for I2S FIFO depth / DMA burst — already implicitly
    done, now documented).
    The root Makefile now greps `parameter EXTENSION_X = N,` lines out
    of hazard3_config.vh and composes the matching gcc -march string in
    canonical extension order:
    rv_ext = $(shell sed -nE 's/...parameter X = ([01]).../\1/p' ...)
    RV_HAS_M := $(call rv_ext,EXTENSION_M)
    ...
    RV_ARCH := rv32i$(M?m)$(A?a)$(C?c)_zicsr$(ZIFENCEI?_zifencei)...
    RV_ARCH and RV_ABI are exported, and test/Makefile consumes them in
    all three compile/link sites that previously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
2026-05-02 xip-cache: optional debug patch for cache hit/miss instrumentation
    Adds patches/xip-cache-debug.patch and wires it into
    scripts/apply_patches.sh behind XIP_CACHE_DEBUG=1. Default off so
    the production RTL stays untouched; sim workflows that want to size
    the cache run
    make sim-verilator XIP_CACHE_DEBUG=1 ...
    and the firmware run prints
    XIP_CACHE_HITS:<n>
    XIP_CACHE_MISSES:<n>
    XIP_CACHE_MISS_RATE:<x.xx>%
    at teardown next to DETECT / CYCLES / IRQS.
    The patch touches the parent repo (kws_soc.v top-level outputs +
    kws_soc_vpi.cpp dump + peris/xip/{ro_cache,ahbl_flash_ctrl_eb_cache}.v
    counter wires). Idempotent apply / revert tested.
    First measurement on mel_compact_4blk_ch3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
2026-05-02 xip: bump cache line count 32 -> 256 (1 KB -> 8 KB) — 56 % faster inference
    Direct measurement on mel_compact_4blk_ch36 + sim/down_0000.hex with
    the patches/xip-cache-debug.patch counters confirms each cache miss
    costs ~155-196 cycles for a QSPI line fetch — far above the rough
    30-80 cycle estimate that motivated the experiment. Sweep:
    NL cache miss rate CYCLES_INFER vs base BRAM
    32 1 KB 1.33 % 105,007,236 0 % ~1 KB
    128 4 KB 0.24 % 52,673,468 -50 % ~4.3 KB
    256 8 KB 0.09 % 45,843,053 -56 % ~8.7 KB
    1024 32 KB 0.00 % 41,115,805 -61 % ~34 KB
    NL=256 is the knee: 92 % o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
2026-05-02 test: consolidate NNoM models under test/model/<name>/
    Resolves part (1) of TODO #7. The pre-reorg layout had three
    parallel directories holding model assets that had drifted apart:
    test/model/ <- strided_s16_nodil weights only
    test/mel_compact/ <- mel_compact_4blk_ch36 weights + README
    test/streaming_model/ <- streaming engine + bare-stream firmware
    After:
    test/model/strided_s16_nodil/ strided_s16_nodil_weights.h
    test/model/mel_compact_4blk_ch36/ mel_compact_4blk_ch36_weights.h
    README.md
    test/model/streaming/ kws_bare_stream.c
    kws_stream_b.c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
    [kws_bare_stream.c, strided_s16_nodil_weights.h]
2026-05-02 test/xip: self-checking ro_dmc testbench (8 cases, 26 assertions)
    Replaces the prior 4-read print-only smoke test with a proper
    self-checking suite that exercises:
    1. Cold miss on slot 0 (line 0)
    2. Same-line hit on word 1
    3. Same-line hit on the last word of the line (boundary)
    4. Cold miss on slot 1 (different cache slot)
    5. Conflict miss on slot 0 (different tag, evicts test 1)
    6. Thrash back to test 1's address (re-fetch)
    7. Sequential reads spanning a line boundary
    8. Repeated hit on the same word (steady-state)
    Each case asserts both the returned data (cpu_data === expected)
    and the stall cycles (<= bound for misses, == 0 for hits) so a
    regression in either the data p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
    [ro_dmc_tb.v]
2026-05-02 test/xip: per-word flash model + CWF-shaped tests in ro_dmc_tb
    Replaces the 5-cycle-flat mock flash with a per-word arrival model
    that matches the real flash_ctrl_eb's behaviour (one word lands per
    cycle, m_word_done[K] goes high as word K's last byte arrives,
    m_done pulses after the final word). Adds three new tests aimed
    specifically at the upcoming CWF implementation:
    9. CWF early restart on word 0 — fetch with offset 0x00 should
    complete in ~2 cyc with CWF (loose bound 12 cyc today).
    10. CWF stale-bit regression — back-to-back miss to a new line.
    Catches the exact bug that locked up the CPU on the first
    CWF attempt: stale m_word_done bits from the previous f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
    [ro_dmc_tb.v]
2026-05-02 xip: ro_cache CWF (gated by `+define+CWF), TB-validated
    Adds critical-word-first / early-restart support to ro_dmc. Behind
    `+define+CWF (default off in production), the cache:
    * Latches fetch_line_reg / fetch_tag_reg on the miss so the CWF
    hit path doesn't depend on TAG[NL] (which we still only write
    at m_done, preserving the no-CWF behaviour).
    * Builds a per-word valid bitmap `fwv` from the rising edges of
    m_word_done, resetting at miss start. The rising-edge filter
    is essential — m_word_done is a level that stays high until the
    next start, and that start propagates through the wrapper FSM
    after a few cycles, so the first cycles of ST_FETCH still see
    sta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
    [ro_cache.v, ro_dmc_tb.v]
2026-05-02 .gitmodules: rename nnom submodule section + switch to SSH URL
    The earlier `git mv third_party/nnom nnom` updated the submodule's
    `path` but left two artefacts behind:
    1. The section header was still `[submodule "third_party/nnom"]`,
    so the submodule's *logical name* (which decides the
    .git/modules/<name> metadata directory) was still
    "third_party/nnom" while the worktree lived at "nnom". That
    mismatch confused `git submodule deinit` and meant a fresh
    clone would create .git/modules/third_party/nnom even though
    the working path is nnom.
    2. The url was still HTTPS (https://github.com/INITRAMFS-AUC/nnom.git)
    while every other submodule in this repo uses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
2026-05-02 test/xip: total-stall metric + word-offset sweep — quantifies CWF win
    Adds an accumulator that sums stall cycles across every ahb_read in
    the run, plus a 13th test case that sweeps cold misses across every
    word offset 0x00..0x1c. The summary line now prints
    total_stall=N cyc across M misses (avg N/M cyc/miss)
    so running the TB once with the baseline cache and once with
    `+define+CWF directly quantifies the CWF speedup.
    Measured on the current cache:
    baseline: total_stall=159 cyc / 16 misses (avg 9 cyc/miss)
    CWF: total_stall=105 cyc / 16 misses (avg 6 cyc/miss)
    saving: -54 cyc / -34 % / -3 cyc avg per miss
    The TB mock flash returns one word per cycle. The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
    [ro_dmc_tb.v]
2026-05-02 xip: position-based byte writes + per-word ready bitmap in flash_ctrl_eb
    flash_ctrl_eb used to assemble the line by shifting each byte in from
    the top of data_reg, so no slot was observably correct until m_done.
    Switch to position-based writes (data_reg[byte_idx*8 +: 8] <= byte) and
    add a level-held word_done[K] bitmap that goes high when byte 4K+3 of
    word K lands. Plumb the new wire through ahbl_flash_ctrl_eb_cache to
    ro_dmc.
    Functionally identical for the full-line consumer; required for the
    critical-word-first / early-restart path that follows.
    [ahbl_flash_ctrl_eb_cache.v, flash_ctrl_eb.v]
2026-05-02 xip: critical-word-first / early-restart in ro_dmc — always-on
    ro_dmc tracks the rising edges of m_word_done into a fwv bitmap that
    resets at miss entry, mirrors m_data into DATA[fetch_line_reg] every
    ST_FETCH cycle, and adds an early-restart hit (ahit_cwf / dhit_cwf)
    that releases the master as soon as fwv[requested_word] sets — instead
    of waiting for the full line. A deferred-miss rescue branch in
    ST_IDLE catches the address phase the master issues mid-fetch after
    the early restart, which would otherwise deadlock the bus.
    Speed-up on mel_compact_4blk_ch36 over 200M cyc / 3 inferences:
    baseline 45,840,820 → CWF 45,276,184 cyc/infer (-1.2%). Modest in
    the SoC because most i-fetches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
    [ro_cache.v, ro_dmc_tb.v]
2026-05-02 docs/TODO: CWF shipped — collapse XIP cache entry to next-line prefetch only
    CWF / early-restart landed in ed8732d; the open item now is just
    next-line prefetch. Reference the −1.23 % SoC win and the −34 % TB
    stall result so the next reader has the perf context for prefetch.
2026-05-02 test/kws_bare_main: drop legacy CYCLES: print
    CYCLES: was kept as an alias for CYCLES_INFER while old log scrapers
    caught up. No remaining consumers in the tree (grep -r '"CYCLES:'
    returns nothing); remove the line and its docstring entry to keep
    the per-clip output to the three counters that actually matter.
2026-05-02 test: rename kws_lr weights header + add SRAM model build targets
    Rename test/model/kws_lr/weights_lr.h → lr_weights.h. No references
    in tree (file is currently orphaned — the kws_lr model has no main.c
    yet); rename brings it in line with the <name>_weights.h convention
    the other models use.
    Add SRAM build rules + SRAM_TARGETS entries for all three NNoM models
    (mel_compact_4blk_ch36, strided_s16_nodil, streaming_model). These
    link with sram_link.ld so text + rodata + data + bss all live in SRAM
    at 0x00000000 — no flash, no XIP cache misses, no QSPI latency. Use
    them via GDB `load` + `continue` to measure a clean lower-bound
    CYCLES_INFER and quantify how much of the inference budget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
2026-05-02 sim: SRAM_PRELOAD=<bin> knob to boot directly from SRAM
    Adds a one-flag way to load an SRAM-linked .bin into sram0 via
    $readmemh and boot the CPU out of it. Used to measure a baseline
    that excludes all flash / XIP-cache cost. Setting SRAM_PRELOAD does
    three things:
    1. runs scripts/bin2hex.py to convert the .bin into the
    $readmemh-friendly hex format ahb_sync_sram's PRELOAD_FILE
    parameter expects (one little-endian 32-bit word per line)
    2. defines SRAM_PRELOAD_HEX for Verilog elaboration; kws_soc.v
    gates the sram0 PRELOAD_FILE attribute and the Hazard3
    RESET_VECTOR / MTVEC_INIT (-> 0x00000000) on it
    3. makes the verilator / cxxrtl sim build depend on the hex file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
    [bin2hex.py, kws_soc.v]
2026-05-03 docs/TODO: next-line prefetch tried, regresses — record the why
    Implemented chained next-line prefetch in ro_dmc (TB 54/54 PASS,
    prefetched lines hit at 0 stall) but it regresses CYCLES_INFER from
    45.28M to 50.68M (+11.9 %) on mel_compact_4blk_ch36. CWF_DEBUG counts
    show why: demand misses only drop −3.5 % (most i-misses are branches
    not sequential), while total flash fetches more than double, and ~40 %
    of demand misses now collide with an in-flight wasted prefetch.
    The cache hit rate is already 99.91 % — there's almost no spatial
    locality left to redeem the bus contention cost. Reverted; don't
    re-try without victim-buffer isolation, abort-able QSPI fetches, or
    a much lower-hit-rate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
2026-05-03 docs/TODO: prefetch-vs-cache-size sweep — regresses at every NL
    Swept (NL, prefetch) over NL ∈ {32, 64, 128, 256} on mel_compact.
    Counter-intuitive result: prefetch gets *worse* as the cache
    shrinks, not better. At NL=32 (1 KB) inference doesn't even finish
    in 300M cycles — eviction cascade.
    Updates the prior single-NL=256 finding with the full curve, and
    sharpens the conditions under which prefetch could be re-tried:
    needs victim-buffer isolation, abort-able QSPI fetches, or
    confidence prediction so we don't prefetch on every miss.
2026-05-06 peris/conv1d_accel: RTL + design doc + self-checking testbench
    Adds the Conv1D hardware accelerator that replaces NNoM's SW conv2d
    on the int8 KWS path. APB slave for config registers (8 KB region at
    0x4000_C000), AHB-Lite master for DMA reads/writes against SRAM and
    XIP flash. Loop order is C_out (outer) × W_out (inner) so the weight
    buffer is loaded once per output channel and reused across all output
    positions, amortising XIP flash read cost. Two bigger optimisations:
    - Word-aligned weight bursts when patch_bytes is %4 and wt_addr is
    word-aligned (4×: byte → word reads).
    - Ping-pong input buffers (in_buf0 / in_buf1): while MAC executes
    on the active buffer, the AHB mas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
    [conv1d_accel.v, conv1d_accel_tb.v]
2026-05-06 peris/xip: add xip_sample_player (gated by \`XIP_PLAYBACK)
    Adds a read-only AHB-Lite master that streams pre-recorded audio
    samples from XIP flash at 0x8001_0000 and feeds them serially into
    the I2S receiver's sd input. Replaces the external mic pin in
    simulation and FPGA bring-up flows when the live mic isn't wired,
    so kws_soc can be exercised end-to-end with a known-good clip.
    The player taps the receiver's own sck_out / ws_out so the receiver
    still drives I2S timing; sd_out feeds an i2s_sd_internal mux in
    kws_soc.v. N_SAMPLES is parameterised by the \`XIP_N_SAMPLES Verilog
    macro (root Makefile derives it as PLAYBACK_SAMPLES_NUMBER × 8000)
    so multi-clip hex files don't need an RTL edit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
    [xip_sample_player.v]
2026-05-06 kws_soc: wire conv1d accel as 4th master, relocate snooper, gate xip_player
    AHB crossbar: N_MASTERS 3 → 4 (production) or 5 with \`XIP_PLAYBACK.
    New master ordering is {playback (XIP_PLAYBACK), accel, dmac, d, i};
    production CONN_MATRIX = 16'b1001_0011_1111_1001 — accel reaches
    SRAM + XIP only (it doesn't need the bridge or DMAC regs).
    APB splitter: N_SLAVES 3 → 5. Slot map repacked so accel and the
    debug snooper coexist:
    timer 0x0000-0x3FFF (16 KB)
    uart 0x4000-0x7FFF (16 KB)
    i2s 0x8000-0xBFFF (16 KB)
    accel 0xC000-0xDFFF ( 8 KB)
    snooper 0xE000-0xFFFF ( 8 KB) \`ifdef DEBUG_SNOOPER
    Per-slot ADDR_MASK lets the splitter use the existing apb_splitter
    with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
    [kws_soc.v]
2026-05-06 submodules: bump peris/i2s + peris/MS_DMAC_AHBL
    peris/i2s 876a6e2 → 4335f2f (q8-sel-flag)
    peris/MS_DMAC_AHBL 1999430 → a79aece (pirq fix again)
    i2s pulls in three upstream improvements + one project-local commit:
    - ee863e3 i2s INMP441 alignment: i2s_rx_core skips the leading Z
    SCK cycle and captures only the 24 audio bits at shifter[23:0],
    matching the real INMP441 protocol (1 Z + 24 audio MSB-first +
    7 trailing Z).
    - 9e7a84a i2s fix again: replaces the cfg_q8_en bit with a 2-bit
    cfg_width (00=32b, 01=16b, 10=8b 4-packed) and reorganises the
    downsampler to 3× decimation (drop 2 of 3) when cfg_ds_en=1.
    - 4335f2f i2s WIDTH=8: compile-time Q8_SEL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
2026-05-06 patches: silence upstream-submodule lint warnings, plumb through apply_patches
    Adds four project-local patches against immutable submodule trees,
    applied at build time by scripts/apply_patches.sh and reverted by
    make clean (idempotent both ways). Each addresses a Verilog lint
    warning that breaks strict ASIC / Quartus flows:
    hazard3-timescale.patch Adds \`timescale 1ns/1ps to all Hazard3
    HDL files missing it. Otherwise mixed-
    timescale modules trigger TIMESCALEMOD
    and some flows error out.
    libfpga-uart-fixes.patch Width fixes in uart_mini.v (tx/rx_over_ctr
    LOGNOT, txfifo/r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
2026-05-06 quartus/CycloneV: pin map updated for the merged-PCB layout
    Re-pinned JTAG / UART / I2S / QSPI flash to the GPIO header positions
    the production PCB exposes:
    JTAG tck=AG1, tdi=AJ1, tdo=AH4, tms=AH2, trst_n=Y16
    UART rx=AK2, tx=W15
    I2S ws=AG7, sd=AF4, sck=AG5
    QSPI csn=AD7, sck=AE11, io[0]=AC12, io[1]=AD10, io[2]=AD12, io[3]=AA12
    Adds weak pull-ups on tms / tdi to keep the JTAG signals defined
    when the chain isn't being driven. The XIP flash pull-ups (csn,
    io[2:3] for WP#/HOLD#, optional io[0:1]) carry over unchanged.
2026-05-06 scripts: helpers for batch sim, audio hex generation, validation
    Adds the helper scripts the conv1d-accel + XIP-playback flows need:
    run_soc_batch.sh Loops sim/<keyword>_0000.hex through
    Verilator with a given firmware .bin and
    aggregates DETECT / CYCLES outputs into a
    per-clip accuracy + cycle-count table.
    Used to spot-check the 11-class KWS path.
    hex_to_c_array.py Converts an I2S-format .hex into a
    playback_samples.c source compatible with
    xip_sample_player.v's .playback_samples
    linker section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
2026-05-06 sim: add 11 keyword test clips, doubled-paired variants, XIP playback assets
    Adds the audio test fixtures used to exercise the conv1d accelerator
    end-to-end:
    sim/{down,go,left,no,off,on,right,stop,unknown,up,yes}_0000.hex
    11 single-clip Q7 8000-sample stimuli derived from the GSCD
    eval set. Each line is one 32-bit I2S frame in the legacy
    'q7 << 16' convention (q7 byte at hex[23:16]).
    sim/<keyword>_0000_ds.hex
    Doubled-with-zero-interleave variant of each (16000 entries)
    generated via scripts/double_hex.py. Required by the new
    cfg_div=17 + firmware-÷2 audio path: the mic feeder consumes
    samples at 15.625 kHz so 1 second of audio needs 16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
2026-05-06 test/common: adopt CONV_R audio path + accelerator firmware glue
    Replaces test/common/kws_bare_main.c with the CONV_R-derived two-
    stage audio path (HW capture at ~16 kHz, firmware ÷2 to ~8 kHz model
    input) and adapts I2S_CLK_DIV for our 36 MHz target:
    raw_rate = clk / (128 × (cfg_div + 1))
    cfg_div = 17 → SCK = 1 MHz, raw = 15625 Hz, firmware ÷2 = 7812.5 Hz
    The 1 MHz SCK keeps the INMP441 mic out of low-power mode (vs the
    500 kHz the legacy cfg_div=35 produced). HW DS_EN is left off — its
    3× decimator would over-shoot the 8 kHz target. The capture loop
    snapshots RING_SAMPLES_PER_CLIP bytes every clip and decimates with
    a stride-2 read into nnom_input_data:
    for (j = 0; j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
    [accel_conv1d.h, kws_bare_main.c, nnom_conv1d_hw.c]
2026-05-06 test: standalone accel test + I2S record/read tests, register-layout aware
    test/accel/accel_test.c
    Pure SRAM unit test that exercises the conv1d accelerator
    through accel_conv1d.h with three hand-rolled cases. TC1 +
    TC2 are known-failing with the current address-misalignment
    limitation (input HSIZE_WORD on stride×C_in not %4); kept
    in place as a documented regression marker. TC3 passes —
    confirms the basic MAC + bias + shift + write path.
    test/i2s/c/readI2s.c
    Updates the q8 quantization test for the new register layout
    (cfg_q8_en bit replaced by cfg_width[1:0]). q8_en=1 maps to
    WIDTH=8 (4 packed int8s/word); q8_en=0 le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
    [readI2s.c, recordI2s.c]
2026-05-06 test/model: add mel_compact_int8 + mel_compact_int8_peak_norm weight headers
    Adds two new model variants under main's test/model/<name>/<name>_weights.h
    convention:
    test/model/mel_compact_int8/
    NNoM weights for the mel_compact_4blk_ch36 architecture
    quantized to int8 with the no-QAT float-new-noise pipeline.
    Drop-in for the existing mel_compact build target — same
    NNOM_STATIC_BUF_KB=36, same SRAM budget.
    test/model/mel_compact_int8_peak_norm/
    Same architecture, fine-tuned on Barbary INMP441 mic data
    using the int8 peak-normalisation path (>>8 then scale to
    int8 range). Reports 95 % accuracy on Barbary mic data and
    80.7 % on the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
    [mel_compact_int8_weights.h]
2026-05-06 build: new conv1d-accel + XIP-playback build targets and Makefile knobs
    test/Makefile additions:
    - NNOM_SRCS_ACCEL — trimmed NNoM source set (no nnom_conv2d.c, no
    LSTM/GRU/concat/dw/dilated layers; pulls in nnom_conv1d_hw.c).
    Linker resolves conv2d_run directly from the HW shim — no
    -Wl,--wrap (which blocks LTO inlining and added ~800K cycles).
    - PLAYBACK_OBJ glue: when XIP_PLAYBACK=1 the generated
    playback_samples.c is compiled and appended to XIP_LDFLAGS so
    every XIP firmware places audio at flash 0x8001_0000.
    - New XIP build targets:
    mel_compact_4blk_ch36_xip_accel
    mel_compact_int8_xip{,_accel}
    kws_lr_xip{,_accel}
    accel_test_xip
    - Ne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
2026-05-06 docs: TODO follow-ups + READMEs for new accel components
    docs/TODO.md
    P0:
    + test-stimulus provenance unknown — classification regression
    deferred (see also peris/conv1d_accel/README.md "known
    limitations" and the merge commit 7100a3a)
    + push the i2s submodule q8-sel-flag branch upstream
    + accelerator input-misalignment limitation (TC1/TC2)
    P1:
    + conv1d accel landed — perf gate met (1.08M cycles)
    + clock/data gating opportunities tracked for follow-up
    + per-channel SHIFT_ADDR is wired but unused
    + sliding-window inference is now actionable post-accelerator
    P2:
    + APB splitter slot map is hand-coded — make config-driven
    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
2026-05-06 test/spikedebug: import Spike activation-dump harness for layer-by-layer RTL compare
    Pulls test/spikedebug/ from origin/NNOM_DMA_MUL-DIV-UNROLL_CONV_R SHA
    1e99305 ("Add Spike activation debug harness for hardware comparison").
    Self-contained tool to run the int8 peak-norm KWS model on Spike (the
    RISC-V ISS) and dump every NNoM layer's raw int8 output as hex (one
    byte per line) via a layer callback.
    Dovetails directly with the deferred audio-pipeline regression in the
    conv1d-accel merge: the existing sim/<key>_0000.hex stimuli classify
    as 'unknown' on the new RTL because the q7 byte is at hex[23:16] but
    the protocol-correct i2s_rx_core captures the audio window from
    hex[30:7]. Diffing per-l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
    [kws_spike_debug.c, weights_int8norm.h]
2026-05-06 busfabric/ahbl_arbiter: explicit width on mast_gnt_d truth check
    Replaces `mast_gnt_d ? ...` with `|mast_gnt_d ? ...` in the
    dst_hready expression. Verilog's behaviour for a multi-bit
    expression in a ternary condition is "any bit set" — so the
    two are functionally equivalent, but the explicit reduction-OR
    keeps strict lint flows (Quartus -Wfatal, Verilator
    --lint-only -Wall) quiet.
    Cherry-picked from origin/NNOM_DMA_MUL-DIV-UNROLL_CONV_R_DUPE
    SHA 3abd5b7 ("Hardened") — this is the only safe-and-useful
    hunk from that commit. The other hunks in 3abd5b7 either
    break TC3 in the conv1d_accel TB (the wt_buf[buf_idx[5:0]]
    slice change) or roll back main's CWF infrastructure in
    flash_ctrl_eb.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
    [ahbl_arbiter.v]
2026-05-06 build: flip Q8_SEL default MID → MSB to match the RTL's no-define default
    The root Makefile was passing Q8_SEL_MID by default, which silently
    overrode the receiver's no-`define default of raw_data_l[23:16] = MSB
    byte and packed audio[15:8] (middle byte) into the FIFO instead.
    Under the protocol-correct i2s_rx_core (post commit ee863e3 in
    peris/i2s — skip 1 leading Z, capture 24 audio bits at shifter[23:0]),
    the byte the firmware reads as `(int8_t)(fifo >> 16)` IS the MSB byte
    of the audio. That's what the int8 KWS models are trained against —
    documented in the user note "the model was actually trained on the
    MSB 8 bits". MID was the legacy main behaviour BEFORE the alignment
    fix lan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
2026-05-06 test/i2s: end-to-end mic→I2S→DMA→snapshot dataflow self-test
    Adds a self-checking firmware that drives a known counter stimulus
    through the full audio capture path and byte-checks every transform
    at the destination. Purpose-built to lock down the chain integrity
    after the conv1d-accel merge moved the receiver to the protocol-
    correct i2s_rx_core + WIDTH=8 packing + cfg_div=17 + firmware-÷2
    audio path.
    scripts/gen_counter_hex.py Generates the counter stimulus. Each
    frame is `((uint8_t)q7) << 23` so q7
    sits at hex bits [30:23] = audio[23:16],
    where WIDTH=8 byte-extract picks it up.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
    [gen_counter_hex.py]
2026-05-06 test/common/kws_bare_main: dynamic sliding window step + AUDIO_LOSS guard
    Replaces the fixed KWS_STEP_SAMPLES=RING_SAMPLES_PER_CLIP back-to-back
    schedule with a dynamic step that adapts to whatever the model is
    actually taking:
    step = clamp(max(KWS_MIN_STEP_RING_BYTES, inference_cycles / cycles_per_ring_byte),
    1, RING_SAMPLES_PER_CLIP)
    Properties:
    - 20 ms minimum cadence (KWS_MIN_STEP_RING_BYTES = RING_HZ / 50 = 320
    ring bytes at 16 kHz, configurable via -D). Fast inferences get
    idle time between bursts; CPU isn't pegged.
    - Inference-time lower bound: we can't slide faster than we can
    infer, so step ≥ inference_in_bytes. The 30 ms accel mel_compact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
    [kws_bare_main.c]
2026-05-06 test/i2s: slide_test — sliding-window ring-buffer self-test
    Drives a 32000-frame counter stimulus through the same dynamic
    sliding-window logic kws_bare_main now uses, simulates inference
    with a configurable busy-loop, and verifies every snapshot's first
    and last byte against the expected counter pattern after the
    explicit step.
    Pin-points correctness of:
    - Step math (max/min clamps, inference-cycles → ring-byte conversion)
    - Anchored snap_start (window position tracks bytes_at_next_inference,
    not the floating bytes_written)
    - No-audio-loss invariant (snap_start ≥ bytes_written - KWS_RING_SAMPLES)
    - Ring wrap math across 10+ iterations
    Output:
    ITER N: bytes_at_next=<x>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
    [slide_test.c]
2026-05-06 scripts: import the Spike-comparison + interactive-configure helpers from NDMCR_AWR_DEV
    configure.py Interactive build configurator. Walks the
    user through mode (sim / FPGA), per-knob
    prompts (description, default, choices) for
    every env var that affects the chosen flow,
    target selection, and the resolved `make`
    command before invoking it. Stdlib only,
    no third-party deps. Run with `--list` to
    dump the knob table or `--dry-run` to walk
    the prompts without invoking make.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
    [configure.py, spike16k_to_mic_hex.py]
2026-05-06 test/spikedebug: add SoC-side Spike-repro firmware + mic-BFM stimulus
    kws_spike_repro.c Bit-exact reproduction of kws_spike_debug.c
    (the Spike harness) for the SoC firmware.
    Feeds Spike's clip 0 directly into
    nnom_input_data via spike_clip[] (no I2S /
    DMA path), registers the same per-layer
    activation-dump callback as kws_spike_debug,
    emits the same LF-only "%02x" hex stream so
    a `tr -d '\r' | diff` against
    test/spikedebug/activations.log isolates any
    la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
2026-05-06 test/common/kws_bare_main: dynamic step counts full iter wall time, not just model_run
    The sliding-window step was computed from `mcycle` measured around
    model_run() only, then converted to ring bytes via CYCLES_PER_RING_BYTE.
    That under-counts the per-iteration wall time by everything else the
    loop does — the 8000-sample snapshot loop into nnom_input_data
    (~80 K cycles), softmax, and UART output (variable, dominant when
    KWS_QUIET=0).
    The DMA fills one ring byte every CYCLES_PER_RING_BYTE cycles
    unconditionally, so bytes_written advances by *iter_wall* / 2250
    bytes per iter while bytes_at_next_inference advances by only
    *model_run_cycles* / 2250. The drift accumulates linearly; once it
    c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
    [kws_bare_main.c]
2026-05-07 firmware: bytes_written-anchored sliding step + 200 ms vote-gated UART; bump I2S FIFO to 64
    Three correctness fixes that together drop AUDIO_LOSS events under the
    production accel build by ~5× in 200 M-cycle Verilator sim
    (mel_compact_int8_xip_accel, sim/playback_samples.hex):
    pre-fix 37 AUDIO_LOSS events (mcycle-based step, FIFO=16, per-iter UART)
    post-fix 8 AUDIO_LOSS events (everything below applied)
    1. **bytes_written-based dynamic step** (test/common/kws_bare_main.c).
    The dynamic-step calc previously derived `step_bytes` from
    `mcycle / CYCLES_PER_RING_BYTE`. Two issues with that:
    - CYCLES_PER_RING_BYTE assumes the ring rate matches the I2S
    divider exa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
    [kws_bare_main.c]
2026-05-07 peris/xip: DESIGN.md — long-form documentation of the XIP cache + plan for NNoM-aware prefetch
    Captures everything currently in ro_dmc + ahbl_flash_ctrl_eb_cache +
    flash_ctrl_eb in a single reference doc:
    * Topology (4 AHB masters → cache wrapper → ro_dmc + flash_ctrl_eb).
    * Today's parameters (LW=256, NL=256 → 8 KB direct-mapped).
    * Active optimizations (with measured impact where known):
    1. Direct-mapped tag/valid (baseline).
    2. Critical-Word-First / early restart — −1.23 % CYCLES_INFER.
    3. Deferred-miss rescue — CWF correctness fix.
    4. Stale m_word_done filtering — CWF correctness fix.
    5. Quad-IO Read 0xEB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
2026-05-07 peris/conv1d_accel: DESIGN.md — honest accounting of APB slave + AHB master interfaces
    Rewrites the interface-justification section to confront the real
    question head-on: "why not skip APB and put conv1d's config interface
    on AHB directly, since the CPU is already an AHB master?"
    Quantifies the actual bridge tax:
    * AHB->APB bridge adds ~2 cycles per config write.
    * ~6 register writes per accel call x ~60 calls per inference
    => 360 writes/inference => ~720 cycles/inference of bridge tax.
    * ~0.07 % of today's ~1.05 M-cycle inference. Most is hidden
    behind Hazard3's non-blocking stores anyway; the visible stall
    is only the final ACCEL_CTRL=START drain.
    Then weighs agains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
2026-05-07 peris/conv1d_accel: add gated PREFETCH_CTRL/BASE/LEN side-band registers
    Step 1 of the NNoM-aware XIP cache work (peris/xip/DESIGN.md). This
    commit adds the APB control surface + side-band outputs only; the
    cache wrapper still ignores them. Behavior is byte-for-byte identical
    to before — verified via slide_test (SLIDE_PASS, audio_losses=0).
    New APB regs (paddr[5:2] = 9, 10, 11):
    0x24 PREFETCH_CTRL [0]=PREFETCH_EN. Reset 0. Gates everything;
    when 0, prefetch_base/len are forced low at the
    module boundary so even an unconnected consumer
    sees no stale hint (the gating contract from
    peris/xip/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
    [conv1d_accel.v, kws_soc.v]
2026-05-07 peris/xip: thread NNoM-aware prefetch hint through the cache wrapper into ro_dmc
    Step 2 of the NNoM-aware XIP cache work. Adds the input ports +
    pass-through plumbing on the consumer side; ro_dmc still ignores the
    hint (sinks it to an unused tap) so the gating contract holds:
    behaviour with prefetch_en=0 is byte-for-byte identical to before.
    slide_test rerun: SLIDE_PASS audio_losses=0.
    Files touched:
    * peris/xip/ahbl_flash_ctrl_eb_cache.v — adds prefetch_en /
    prefetch_base / prefetch_len input ports, passes them through to
    * peris/xip/ro_cache.v — adds matching input ports. Today the
    only consumer is a temporary `_unused_prefetch_inputs` tap so
    Verilator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
2026-05-07 peris/xip/ro_cache: NNoM-aware single-line victim buffer + prefetch FSM (gated, default OFF)
    Step 3 of the NNoM-aware XIP cache work. ro_dmc now contains the
    real prefetch logic: a single-line victim buffer (separate from the
    main DATA[] array, so prefetched lines can never evict hot .text)
    and an FSM that fetches the line at PREFETCH_BASE on the rising edge
    of PREFETCH_CTRL.PREFETCH_EN.
    Gating contract — verified bit-for-bit:
    * Production sim (mel_compact_int8_xip_accel, 200 M cycles,
    sim/playback_samples.hex) with PREFETCH_EN=0 (the accel's reset
    default): 8 AUDIO_LOSS / 49 DETECT / CYCLES_INFER ~1.05 M, same
    8 AUDIO_LOSS values in the same order as the pre-prefetch RTL.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
    [ro_cache.v]
2026-05-07 test/common: wire firmware to NNoM-aware XIP-cache prefetch hint (opt-in)
    Step 4 of the NNoM-aware XIP cache work. accel_conv1d() now writes
    PREFETCH_BASE/LEN and pulses PREFETCH_CTRL=1/0 around every accel
    call when KWS_XIP_PREFETCH=1, so the cache pre-warms the first line
    of the weight scan. Default OFF; the RTL gate (PREFETCH_CTRL=0 at
    reset on the accel side) AND the firmware gate (KWS_XIP_PREFETCH=0
    at the test/Makefile level) both default to no-op, keeping the
    no-prefetch behaviour bit-identical to before.
    Measured (mel_compact_int8_xip_accel, sim/playback_samples.hex,
    200 M cyc):
    metric OFF ON delta
    ------------------------- -------- -------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
    [accel_conv1d.h]
2026-05-07 docs: nnom_aware_xip_cache.md — comprehensive walkthrough + measured results
    A single-document reference covering the entire NNoM-aware XIP cache
    work landed across commits 5577de8..03e4fcf:
    * §1 Why a normal cache is leaving cycles on the table.
    * §2 Mechanism: APB regs -> side-band -> victim buffer + FSM,
    with the three FSM rules (demand misses preempt; prefetched
    lines never pollute DATA[]; CWF suppressed for prefetch
    fetches).
    * §3 Gating contract: two layers (runtime PREFETCH_CTRL.EN,
    compile-time KWS_XIP_PREFETCH) both default 0; verified
    bit-perfect via diff of the production-firmware Verilator
    trace.
    * §4 Verification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
2026-05-07 Add mel_compact_int8_pi_kld model; fix driver normalization and add confidence gate
    Model:
    - Add test/models/mel_compact_int8_pi_kld/ with weights_barbary_pi_kld_only.h
    (Barbary-finetuned base model, pi-only KLD calibration; 91% pi / 82% GSCD on Spike)
    Driver (test/common/kws_bare_main.c):
    - Replace rolling AGC with per-clip peak_norm_clip() matching training pipeline:
    scale = min(96/peak, 64), integer arithmetic, applied after snapshot loop.
    The AGC had a fatal shift=10 bug (release always 0 for int8 amplitudes) and
    used target=127 vs training's 96; experiment showed -37% accuracy gap on pi set.
    - Add confidence threshold gate: if max_score < 38 (~30% softmax) force unknown.
    Sk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
    [kws_bare_main.c, mel_compact_int8_pi_kld_weights.h]
2026-05-07 Gate soft-vote accumulator with confidence threshold
    Low-confidence clips (max_score < 38) now skip the vote_score_sum
    accumulator entirely, so background noise and ambiguous utterances
    don't poison the soft-vote window. Previously the threshold only
    gated `pred`/`debounced`, which were never used by the DETECT print
    path — making it dead code. The check is suppressed under
    KWS_DUMP_LAYERS to preserve full layer-dump behaviour.
    [kws_bare_main.c]
2026-05-07 Fix vote-empty→wrong-class regression and iter_bytes scope bug
    Two issues introduced or exposed by the confidence-gating commit:
    1. When confidence gating filters ALL clips in a KWS_PRINT_INTERVAL_MS
    window, vote_score_sum stays all-zero. The argmax unconditionally set
    vote_winner=0 before scanning, so silence was tagged as "down" (index 0)
    instead of "unknown". Fix: guard the argmax on vote_n_clips>0; gate
    default-mode printing on vote_n_clips>0 so zero-clip windows are
    silently suppressed rather than spamming DETECT:unknown lines.
    2. bw_now and iter_bytes were declared inside #else KWS_STEP_SAMPLES but
    used unconditionally in the print_clip block below — compile e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
    [kws_bare_main.c]
2026-05-07 Raise confidence threshold to 60 and require 3 minimum votes
    Two changes to reduce false positives / misfires:
    - KWS_CONF_THRESH: 38 → 60 (~30% → ~47% softmax). Background noise
    rarely scores above 47% for any single class; genuine words reliably
    do. Both the per-clip pred gate and the soft-vote accumulator gate
    now use the same named constant.
    - KWS_MIN_VOTE_CLIPS: require at least 3 confident clips per 200 ms
    window before emitting a DETECT line. A single lucky noise clip can
    no longer trigger a false positive.
    Both constants are -D-overridable so the threshold can be tuned
    without a source edit.
    [kws_bare_main.c]
2026-05-07 docs/slides: 3-slide deck explaining the XIP-cache tricks
    Three slides + diagrams covering everything currently in the cache
    plus the NNoM-aware prefetch we just added. Diagrams are hand-
    written SVG (full control over layout, no auto-router clobbering
    labels) and pre-rendered to PNG via ImageMagick at 144 DPI for
    slide tools that don't render SVG natively.
    Slide 1 — topology + flash side: 4 AHB masters → 8 KB direct-
    mapped cache → QSPI flash with Quad-IO Read 0xEB and
    the per-word ready bitmap that flows back.
    Slide 2 — Critical-Word-First / Early Restart and the two
    correctness fixes it requires (stale-bit filter,
    deferred-mis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
2026-05-07 test/common/kws_bare_main: flip KWS_DS_EN default 0 → 1 (HW downsample)
    Production runs cfg_div=17 (CLK_MHZ=36 → raw frame rate 15.625 kHz).
    With HW DS_EN=1 the receiver itself drops every other frame, so the
    DMA carries ~7.81 kHz worth of bytes (vs 15.625 kHz with HW DS off
    and firmware doing the ÷2). RING_HZ tracks KWS_DS_EN automatically
    (8000 / 16000) so KWS_DECIMATE collapses to 1 — the snapshot loop
    becomes a contiguous 8000-byte memcpy instead of a strided gather.
    Why this is the right default:
    * Halves the DMA byte rate per second of audio → halves the PIRQ
    rate → fewer accel reads have to share AHB arbitration with the
    DMA writer.
    * The model still sees 7.8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
    [kws_bare_main.c]
2026-05-07 docs: audio_loss_analysis — why AUDIO_LOSS could fire even though we're far faster than realtime
    Concise write-up answering "if inference is ~30 ms wall and audio
    arrives at 1 s/clip, how can the audio-loss guard ever fire?"
    Key points:
    1. The guard checks per-iter WALL-TIME variance, not the average.
    Average is fast enough by 30×; AUDIO_LOSS fires when a SINGLE
    iter's wall time exceeds 1 s of audio.
    2. mcycle reports inference at ~1.05 M cycles, but the iter wall
    time can be much higher because of AHB bus contention, XIP
    cache cold misses, and other stalls that mcycle doesn't count
    cleanly. In the prior firmware-÷2 config we measured a
    handful of iters at ~67 M wal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
2026-05-08 Makefile: auto-compute I2S_CLK_DIV from CLK_MHZ for a 16 kHz raw frame rate
    Previously I2S_CLK_DIV was hardcoded (per build-flag override) and the
    README walked users through computing the right value by hand for each
    CLK_MHZ. Wrong if you change the SoC clock without remembering to
    update the divider; silent (the model just gets a slightly off rate).
    Now the root Makefile derives I2S_CLK_DIV from two knobs:
    CLK_MHZ — the SoC clock (default 36, set by gen_pll)
    I2S_RAW_HZ — the receiver's target raw frame rate (default 16000;
    HW DS halves to 8 kHz model rate)
    Formula (integer arithmetic with rounding):
    cfg_div = round(CLK_MHZ * 1e6 / (128 * I2S_RAW_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
2026-05-08 scripts/gen_pll: fail loudly on out-of-range CLK_MHZ instead of producing a broken bitstream
    The script was happy to compute an integer M/C ratio for any CLK_MHZ
    but didn't check that the resulting VCO frequency (= REF_MHZ × M)
    landed inside the Cyclone V ALTPLL band [600, 1300] MHz. Quartus
    silently accepts the IP and only fails at fit-time timing closure
    with an obscure error — wasting a 10-minute synth run before the
    user finds out.
    New checks (in order):
    1. M ∈ [1, 256] — ALTPLL multiplier counter range.
    2. C ∈ [1, 512] — ALTPLL output divider range.
    3. VCO ∈ [600, 1300] MHz — Cyclone V VCO band.
    Each failure prints a concrete error message AND suggests up to f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
    [gen_pll.py]
2026-05-08 scripts: gen_pll_frac.sh — Quartus-CLI fractional-N PLL generator + first 36.864 MHz output
    Wraps qsys-script + qsys-generate to produce a Cyclone V altera_pll
    configured in fractional-N mode. Solves the "no integer CLK_MHZ
    hits exactly 16 kHz raw I2S" problem: with a 50 MHz reference, the
    integer-N gen_pll.py requires CLK_MHZ in {24, 26, 28, 32, ..., 52}
    which all round to 15.625 kHz (off by 2.34 %); fractional-N can
    target ANY non-integer CLK_MHZ that's a multiple of 2.048 MHz and
    land 16 kHz exactly.
    Usage:
    scripts/gen_pll_frac.sh 36.864
    scripts/gen_pll_frac.sh 28.672 "Cyclone V" 5CSXFC6D6F31C6
    For a 16 kHz raw frame rate target, valid pairs are:
    cfg_div + 1 | CLK_MHZ ex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
    [clock_pll_gen_pll.v]
2026-05-08 .gitignore: drop Quartus IP-wizard runtime log droppings
    qmegawiz / qsys-script leave .cnxerr and qmegawiz_errors_log.txt in
    the cwd when they're interrupted or error out (saw both during the
    fractional-N PLL gen experimentation). Per-clone runtime byproduct,
    never want them committed.
2026-05-08 Makefile + kws_soc: fractional CLK_MHZ default 36.864 MHz, auto-route gen_pll, exact 16 kHz I2S
    Three coordinated changes that make a fractional system clock the
    production default and automate the dispatch into the right PLL flow:
    1. CLK_MHZ ?= 36.864 (was 36). At 36.864 MHz the I2S receiver
    formula (raw_hz = CLK / (128 * (cfg_div+1))) hits exactly 16,000 Hz
    when cfg_div = 17, replacing the previous 15.625 kHz (-2.34 %).
    The model now sees a sample rate that matches its training rate
    exactly.
    2. Makefile dispatches `make gen_pll` based on whether CLK_MHZ has a
    decimal point:
    integer → scripts/gen_pll.py (REF*M/C integer-N ALTPLL)
    fractional → script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
2026-05-08 quartus/ip/clock_pll_gen_frac: regenerate after gen_pll_frac.sh restructure
    Files reorganized by the updated script:
    * qsys-generated inner system renamed
    clock_pll_gen → clock_pll_gen_inner so it doesn't collide with the
    hand-written port-adapter wrapper module that's also named
    clock_pll_gen (this is the module fpga_top.v instantiates).
    * The committed clock_pll_gen.v is now the legacy-port wrapper
    (inclk0/areset/c0/locked) rather than the qsys output.
    * The .qip is renamed back to clock_pll_gen.qip (matching the
    Makefile's GEN_PLL_QIP path) and patched to include both the
    qsys-generated inner module AND the wrapper adapter file.
    Functionally unchanged: still a 50 MHz →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
    [clock_pll_gen_inner.v, clock_pll_gen_inner_pll.v]
2026-05-08 docs/TODO: queue I2S→DMA→SRAM dataflow animation walkthrough
2026-05-08 Makefile: ALL_QUARTUS_SRCS lazy-eval so the PLL .qip actually lands in the project
    The PLL-flow chain hits a parse-time evaluation order issue:
    line 42: SRC_LIST_IP = $(abspath $(GEN_PLL_QIP)) # lazy `=`
    line 55: ALL_QUARTUS_SRCS := $(sort … $(SRC_LIST_IP)) # eager `:=`
    line 84: CLK_MHZ ?= 36.864
    line ~98: GEN_PLL_QIP := quartus/ip/clock_pll_gen…/clock_pll_gen.qip
    Eager evaluation at line 55 expanded SRC_LIST_IP NOW, which expanded
    GEN_PLL_QIP NOW — but GEN_PLL_QIP isn't assigned until line ~98.
    So ALL_QUARTUS_SRCS captured an empty `SRC_LIST_IP` and the .qip
    was dropped from the Quartus project source list.
    Symptom: `make config map` errored out at synthes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
2026-05-08 docs: power_area.md — first Quartus area + power + timing snapshot
    Numbers come from the Quartus 25.1 SC Lite flow on Cyclone V
    5CSXFC6D6F31C6 at the new fractional CLK_MHZ=36.864 default:
    Area (post-fit):
    10,984 ALMs (26 % of the chip)
    14,223 registers
    141 RAM blocks (1.125 Mb total, 20 %)
    17 DSPs (15 %)
    1 PLL (fractional-N, 50 → 36.864 MHz exactly)
    18 pins
    Timing (Slow 1100 mV 85 °C corner):
    clk_50 passes at 50 MHz
    sys_clk @ 36.86 MHz FAILS — worst-case slack -61.956 ns
    (~89 ns critical path; TNS
    -39,098 ns over many endpoints).
    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
2026-05-08 docs/audio_loss_analysis: traced mcycle ≪ wall-time to Hazard3's debug_mode gate
    Added a root-cause section pinning the residual divergence to the
    mcycle_stopped gate in Hazard3's hazard3_csr.v line 590:
    wire mcycle_stopped = mcountinhibit_cy || debug_mode || wen_m_mode
    && (addr == MCYCLEH || addr == MCYCLE);
    Of the three causes, only debug_mode is consistent with the
    observed numbers (mcountinhibit_cy is cleared at boot and never
    re-set; mcycle write stalls are single-cycle). The Verilator
    --no-jtag run shouldn't be entering debug mode in steady state,
    but the data clearly shows ~29 M cycles per iter that mcycle does
    not count (CYCLES_INFER ≈ 1.05 M vs bytes_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
